BornaBiro/Diplomski_rad/Case, 3D models/FreeCAD Files/WindDirection/Notes.txt

Arrow holder: 15% Infill, 4 perimeters, 0,45mm extrusion width
Wing: 15% Infill, 4 perimeters, 0,45mm extrusion width
