BornaBiro/Diplomski_rad/Case, 3D models/FreeCAD Files/RainGaugeTippingBucket/tipping_bucket_holder.FCStd

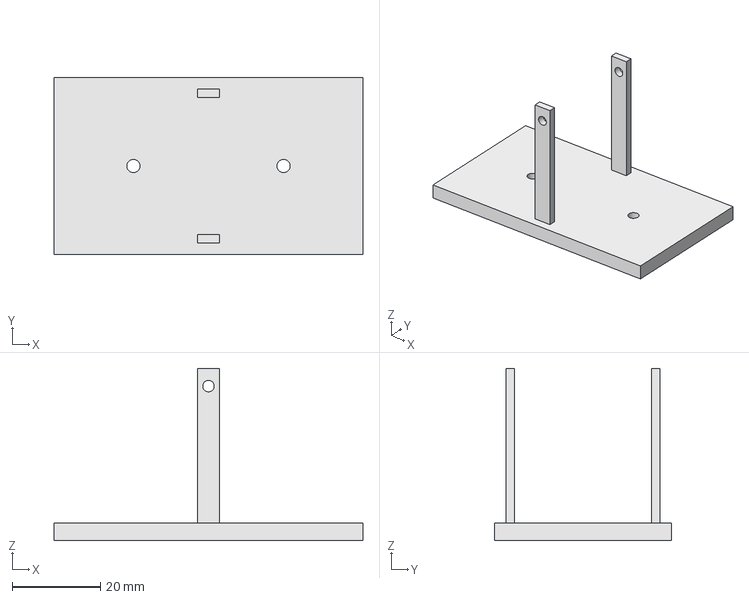
[picture p1: CAD file, 2021-11-29]
Case, 3D models/FreeCAD Files/RainGaugeTippingBucket/tipping_bucket_holder.FCStd
70.0 x 40.0 x 39.0 mm
