BornaBiro/Diplomski_rad/Case, 3D models/FreeCAD Files/solar_panel_clip.FCStd

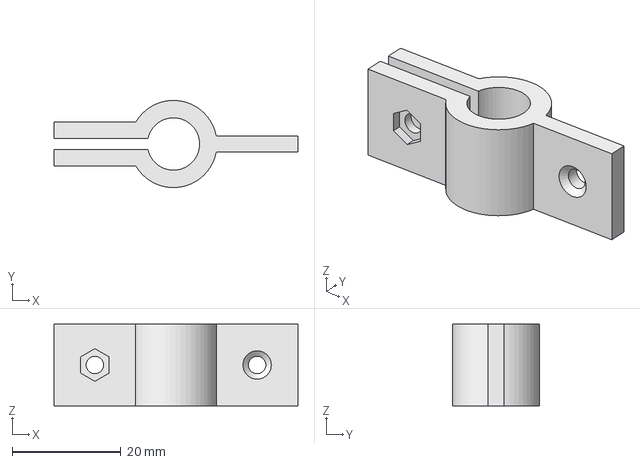
[picture p2: CAD file, 2021-11-29]
Case, 3D models/FreeCAD Files/solar_panel_clip.FCStd
44.8 x 16.0 x 15.0 mm
