BornaBiro/Diplomski_rad/Case, 3D models/FreeCAD Files/WindDirection/windDirectionSensorHousing.FCStd

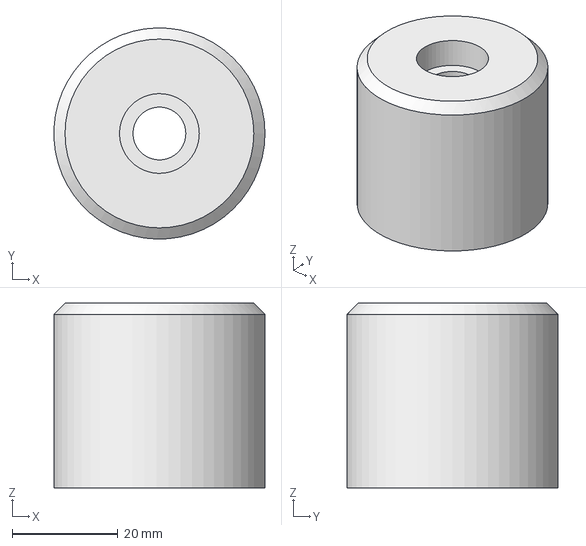
[picture p3: CAD file, 2021-11-29]
Case, 3D models/FreeCAD Files/WindDirection/windDirectionSensorHousing.FCStd
40.0 x 40.0 x 35.0 mm
