BornaBiro/Diplomski_rad/Case, 3D models/FreeCAD Files/WindSpeed/windSensorHolder.FCStd

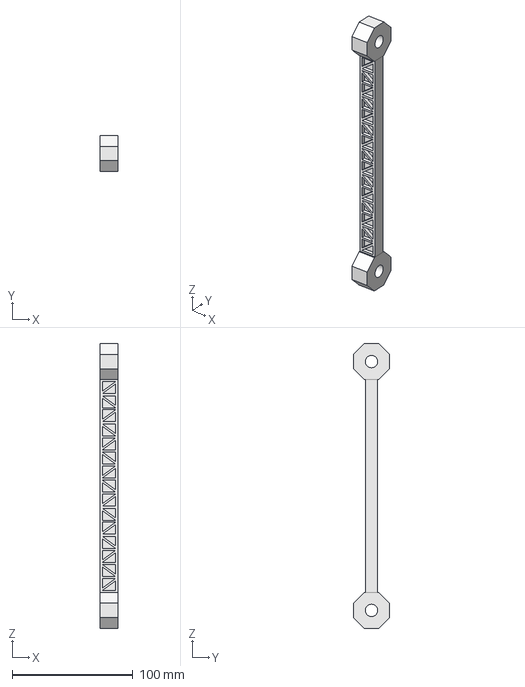
[picture p4: CAD file, 2022-10-31]
Case, 3D models/FreeCAD Files/WindSpeed/windSensorHolder.FCStd
15.0 x 30.0 x 236.0 mm
