BornaBiro/Diplomski_rad/Case, 3D models/FreeCAD Files/Ball_joint1.FCStd

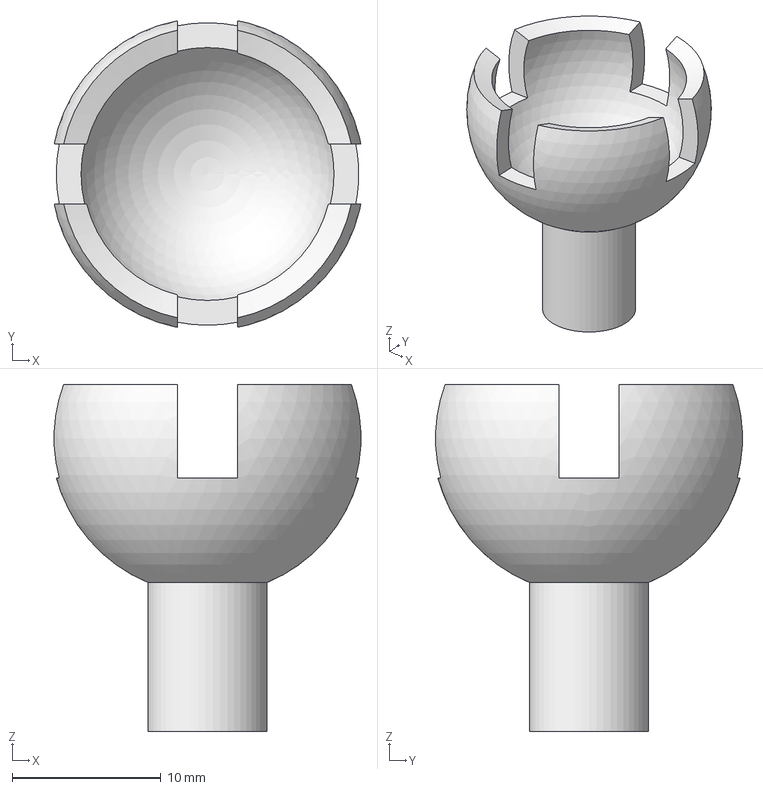
[picture p5: CAD file, 2021-11-29]
Case, 3D models/FreeCAD Files/Ball_joint1.FCStd
20.6 x 20.6 x 23.3 mm
