BornaBiro/Diplomski_rad/Case, 3D models/FreeCAD Files/WindDirection/windDirectionWing.FCStd

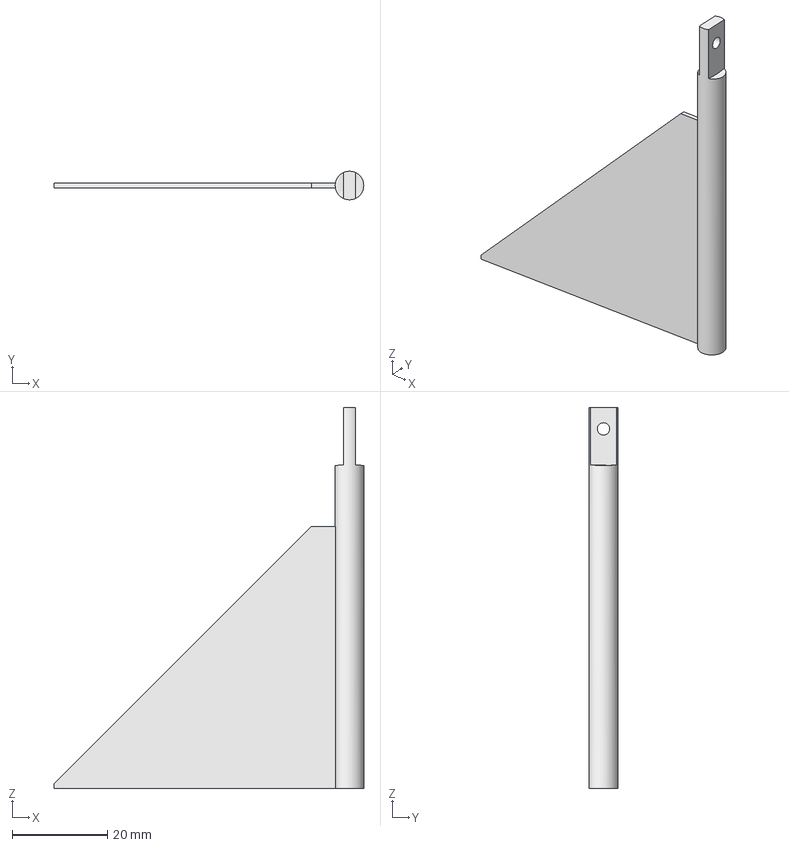
[picture p7: CAD file, 2021-11-29]
Case, 3D models/FreeCAD Files/WindDirection/windDirectionWing.FCStd
65.0 x 6.00 x 80.0 mm
