BornaBiro/Diplomski_rad/Case, 3D models/FreeCAD Files/WindSpeed/bearingHolderWindv3.FCStd

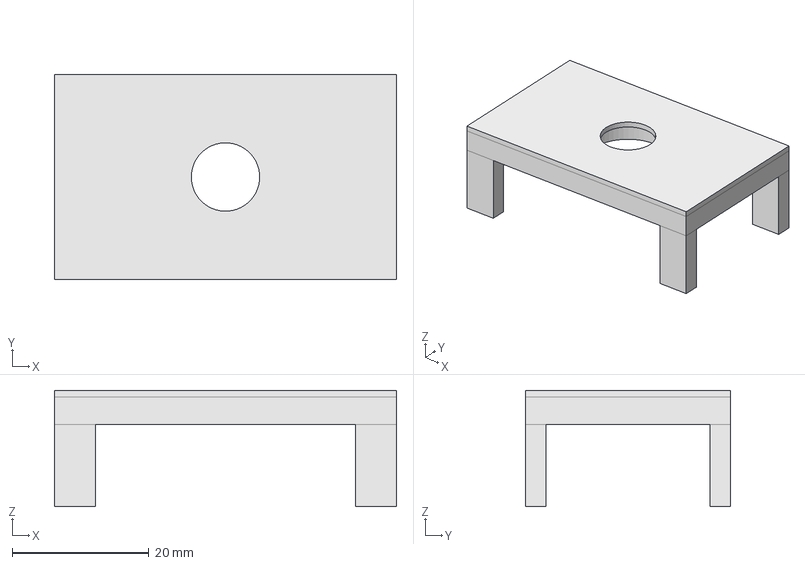
[picture p8: CAD file, 2021-11-29]
Case, 3D models/FreeCAD Files/WindSpeed/bearingHolderWindv3.FCStd
50.0 x 30.0 x 17.0 mm
