BornaBiro/Diplomski_rad/Case, 3D models/FreeCAD Files/Ball_joint2.FCStd

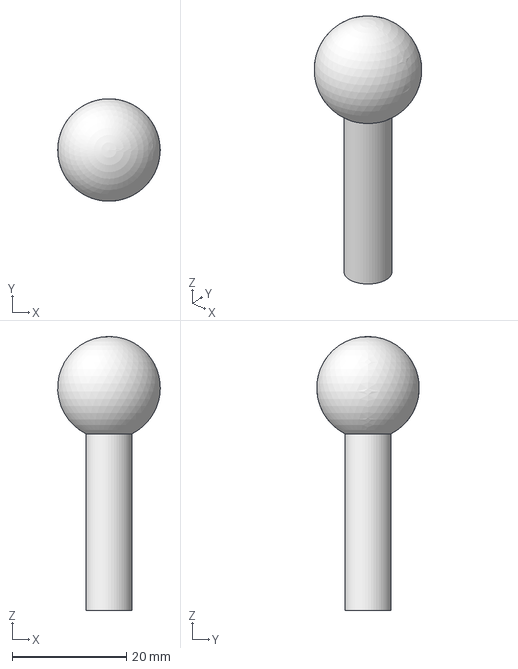
[picture p9: CAD file, 2021-11-29]
Case, 3D models/FreeCAD Files/Ball_joint2.FCStd
18.0 x 17.9 x 48.0 mm
