BornaBiro/Diplomski_rad/Case, 3D models/FreeCAD Files/RainGaugeTippingBucket/2ml.FCStd

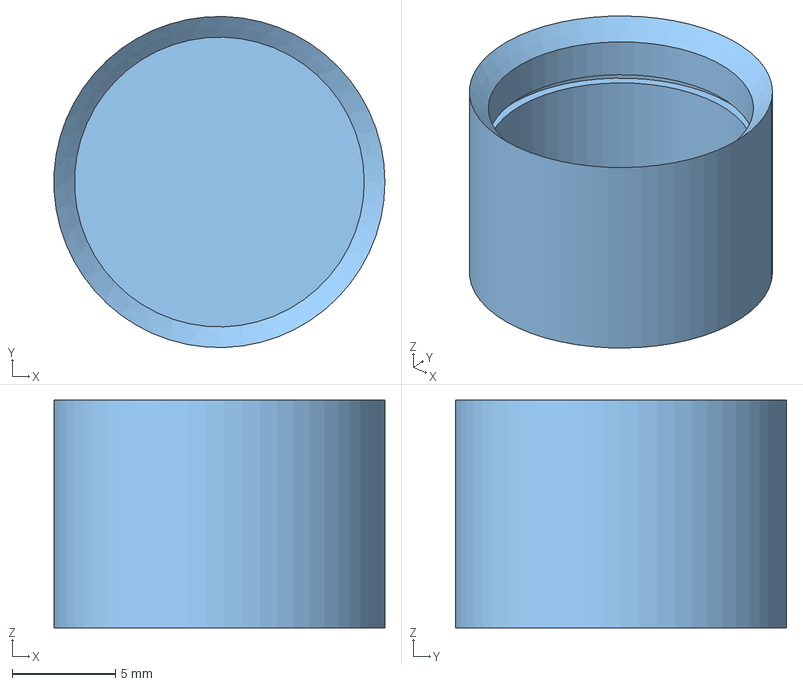
[picture p10: CAD file, 2021-11-29]
Case, 3D models/FreeCAD Files/RainGaugeTippingBucket/2ml.FCStd
16.0 x 16.0 x 11.0 mm
ShapeString
