BornaBiro/Diplomski_rad/Case, 3D models/FreeCAD Files/WindDirection/windDirectionPCB.FCStd

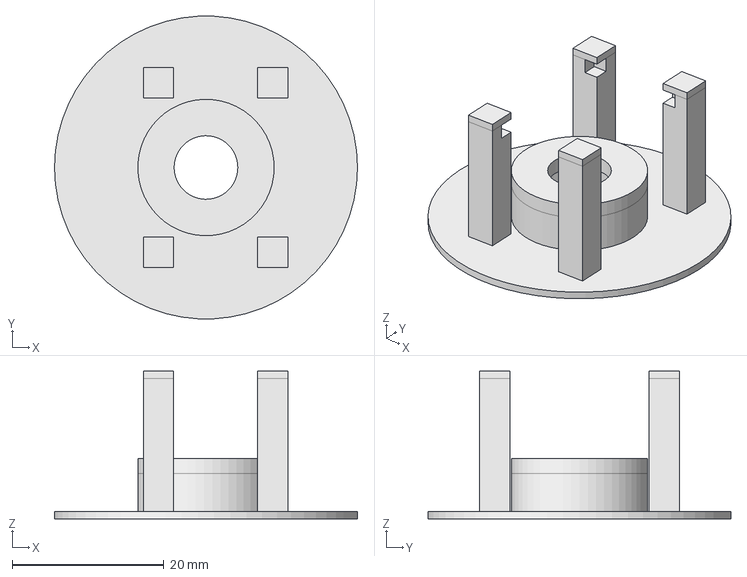
[picture p11: CAD file, 2021-11-29]
Case, 3D models/FreeCAD Files/WindDirection/windDirectionPCB.FCStd
40.0 x 39.9 x 19.5 mm
