BornaBiro/Diplomski_rad/Case, 3D models/FreeCAD Files/WindSpeed/WindGear3.FCStd

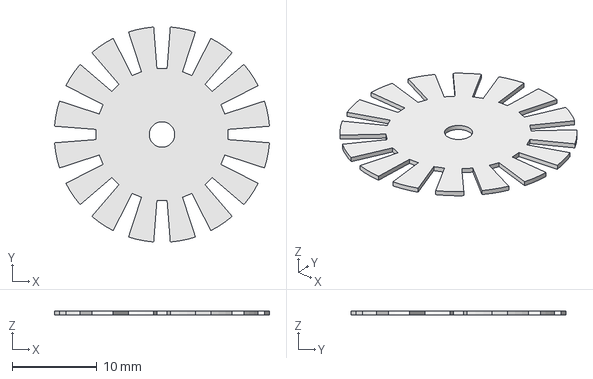
[picture p12: CAD file, 2021-11-29]
Case, 3D models/FreeCAD Files/WindSpeed/WindGear3.FCStd
25.3 x 25.3 x 0.5 mm
