BornaBiro/Diplomski_rad/Case, 3D models/FreeCAD Files/Outdoor_solar_panel.FCStd

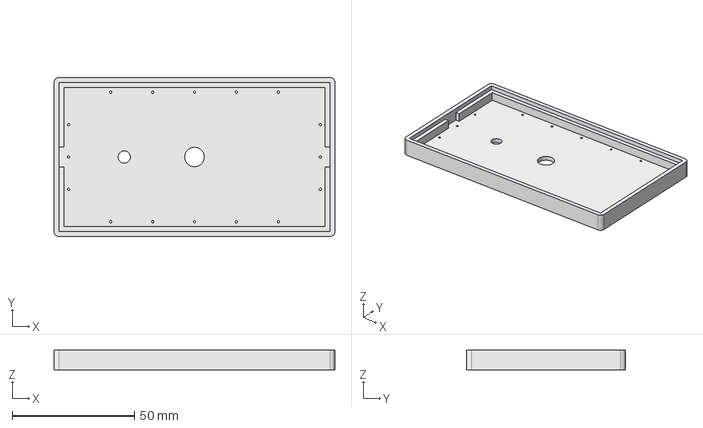
[picture p13: CAD file, 2021-11-29]
Case, 3D models/FreeCAD Files/Outdoor_solar_panel.FCStd
115.0 x 65.0 x 8.00 mm
