BornaBiro/Diplomski_rad/Case, 3D models/FreeCAD Files/RainGaugeTippingBucket/tipping_bucket.FCStd

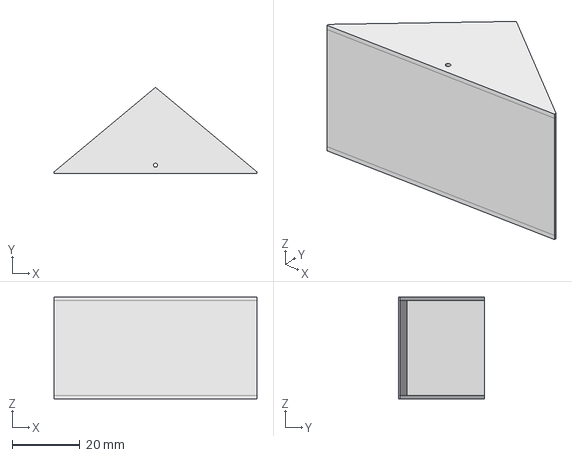
[picture p14: CAD file, 2021-11-29]
Case, 3D models/FreeCAD Files/RainGaugeTippingBucket/tipping_bucket.FCStd
60.0 x 25.5 x 30.1 mm
