BornaBiro/Diplomski_rad/Case, 3D models/FreeCAD Files/WindDirection/windDirectionArrowTop.FCStd

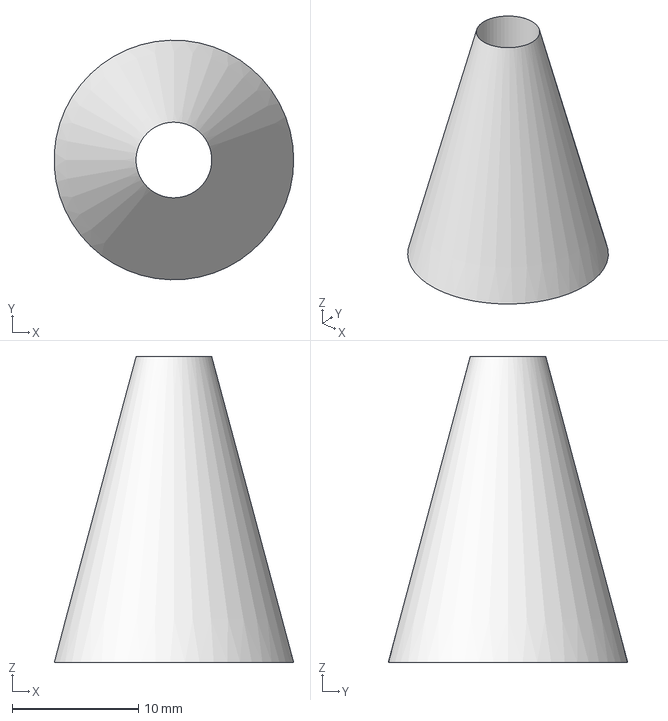
[picture p15: CAD file, 2021-11-29]
Case, 3D models/FreeCAD Files/WindDirection/windDirectionArrowTop.FCStd
19.0 x 19.0 x 24.3 mm
