BornaBiro/Diplomski_rad/Case, 3D models/FreeCAD Files/WindSpeed/windCupv5.FCStd

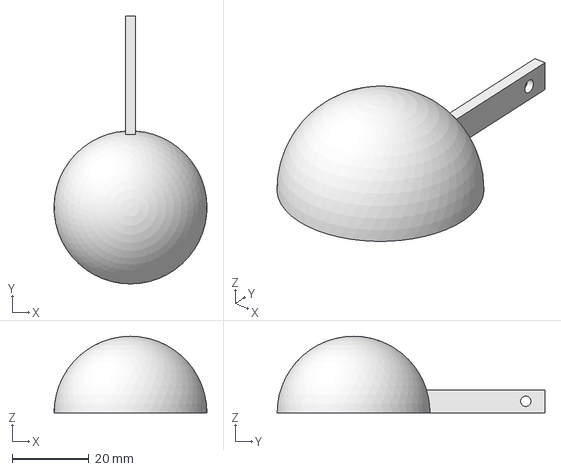
[picture p16: CAD file, 2021-11-29]
Case, 3D models/FreeCAD Files/WindSpeed/windCupv5.FCStd
40.0 x 70.0 x 20.0 mm
