BornaBiro/Diplomski_rad/Case, 3D models/FreeCAD Files/WindDirection/windDirectionArrowHolder.FCStd

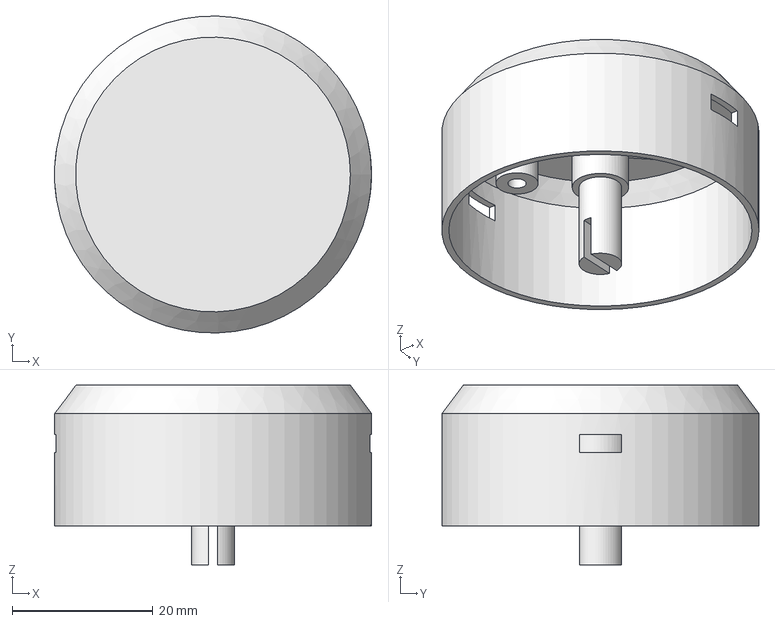
[picture p17: CAD file, 2021-11-29]
Case, 3D models/FreeCAD Files/WindDirection/windDirectionArrowHolder.FCStd
45.0 x 45.0 x 25.5 mm
