BornaBiro/Diplomski_rad/Case, 3D models/FreeCAD Files/WindSpeed/WindGear.FCStd

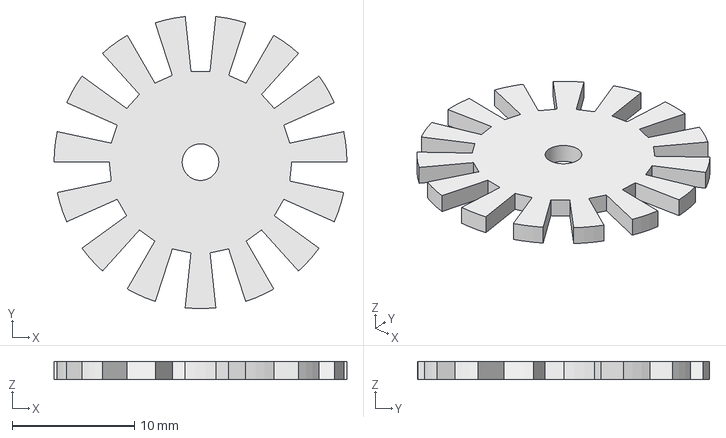
[picture p18: CAD file, 2021-11-29]
Case, 3D models/FreeCAD Files/WindSpeed/WindGear.FCStd
24.0 x 23.9 x 1.50 mm
