BornaBiro/Diplomski_rad/Case, 3D models/FreeCAD Files/WindDirection/windDirectionArrow.FCStd

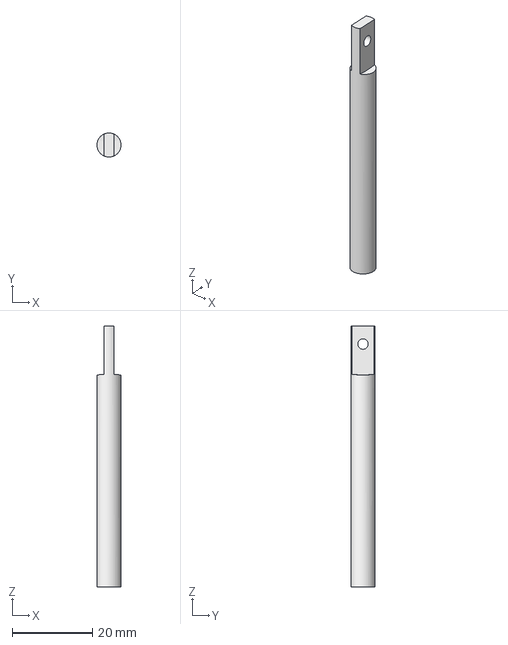
[picture p19: CAD file, 2021-11-29]
Case, 3D models/FreeCAD Files/WindDirection/windDirectionArrow.FCStd
6.00 x 6.00 x 65.0 mm
