BornaBiro/Diplomski_rad/Case, 3D models/FreeCAD Files/WindSpeed/windSensorHousingBottomv2.FCStd

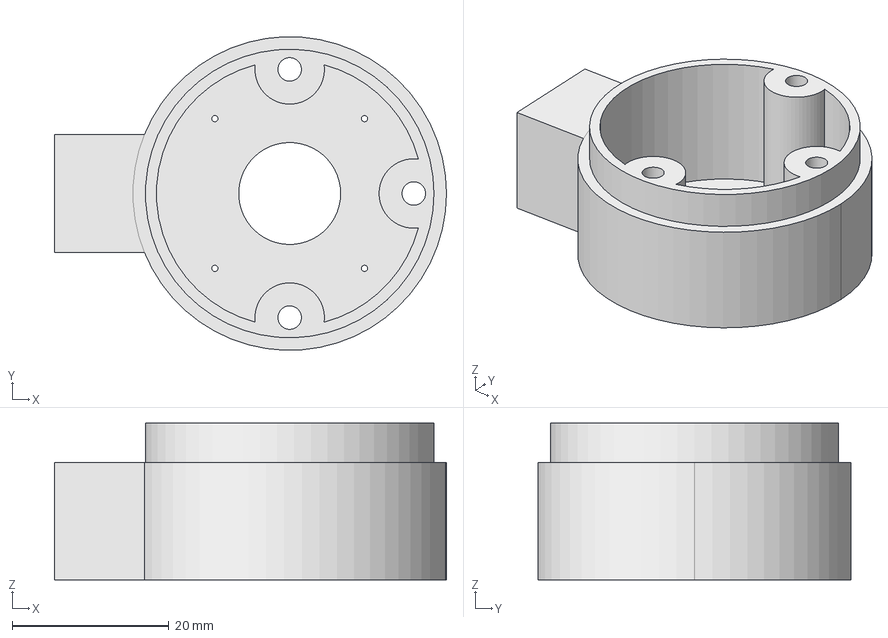
[picture p20: CAD file, 2021-11-29]
Case, 3D models/FreeCAD Files/WindSpeed/windSensorHousingBottomv2.FCStd
50.0 x 40.0 x 20.0 mm
