BornaBiro/Diplomski_rad/Case, 3D models/FreeCAD Files/WindDirection/windDirectionArrowTopv2.FCStd

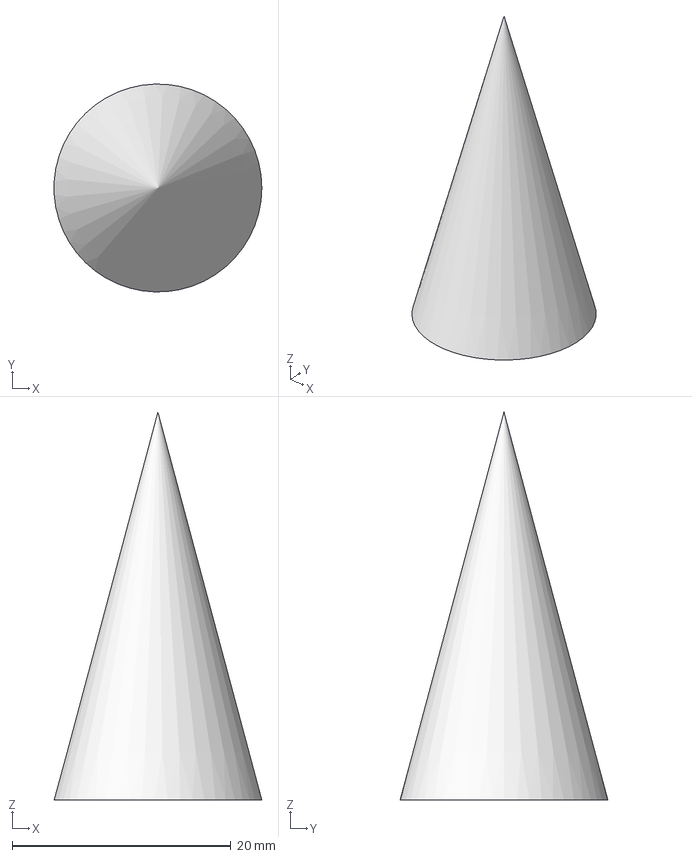
[picture p21: CAD file, 2021-11-29]
Case, 3D models/FreeCAD Files/WindDirection/windDirectionArrowTopv2.FCStd
19.0 x 19.0 x 35.5 mm
