BornaBiro/Diplomski_rad/Case, 3D models/FreeCAD Files/WindSpeed/windCupv4.FCStd

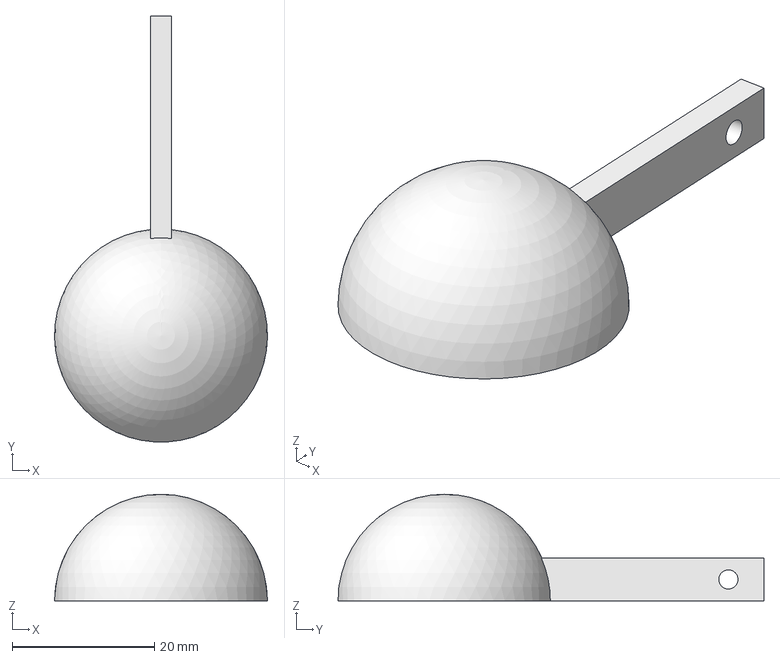
[picture p22: CAD file, 2021-11-29]
Case, 3D models/FreeCAD Files/WindSpeed/windCupv4.FCStd
30.0 x 60.0 x 15.0 mm
