BornaBiro/Diplomski_rad/Case, 3D models/FreeCAD Files/WindDirection/windDIrectionShaft.FCStd

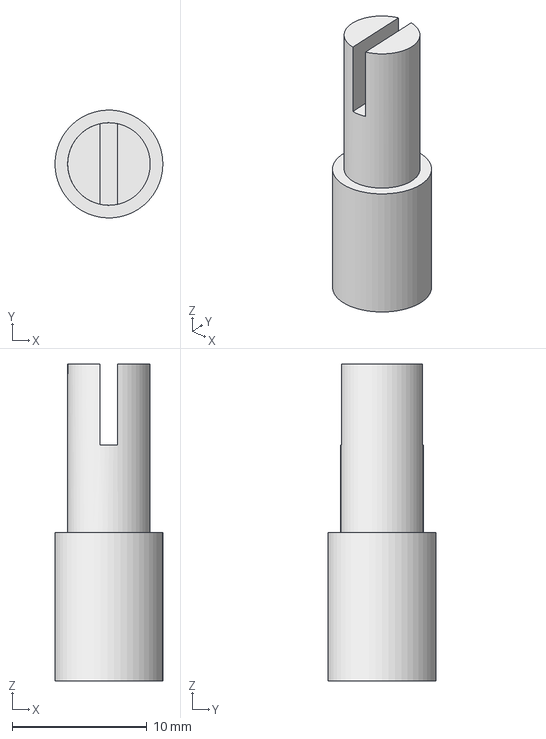
[picture p23: CAD file, 2021-11-29]
Case, 3D models/FreeCAD Files/WindDirection/windDIrectionShaft.FCStd
7.99 x 8.00 x 23.5 mm
