BornaBiro/Diplomski_rad/Case, 3D models/FreeCAD Files/WindSpeed/windCupHolder.FCStd

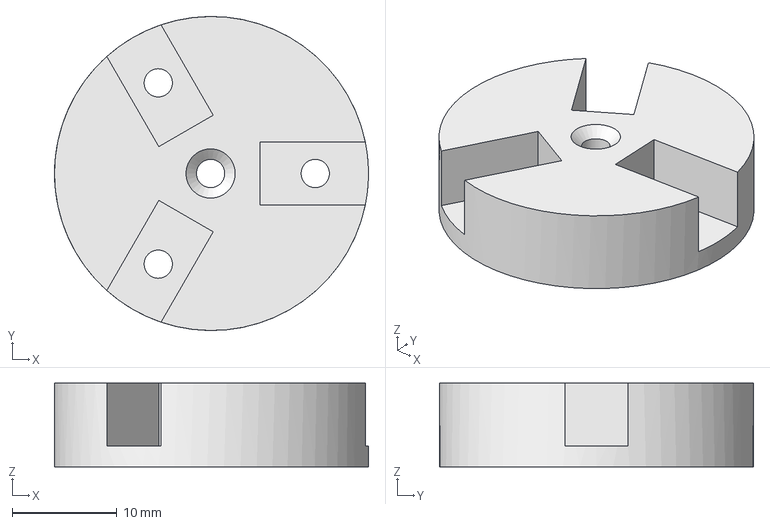
[picture p24: CAD file, 2021-11-29]
Case, 3D models/FreeCAD Files/WindSpeed/windCupHolder.FCStd
30.0 x 30.0 x 8.00 mm
