BornaBiro/Diplomski_rad/Case, 3D models/FreeCAD Files/WindDirection/windDirectionHolder.FCStd

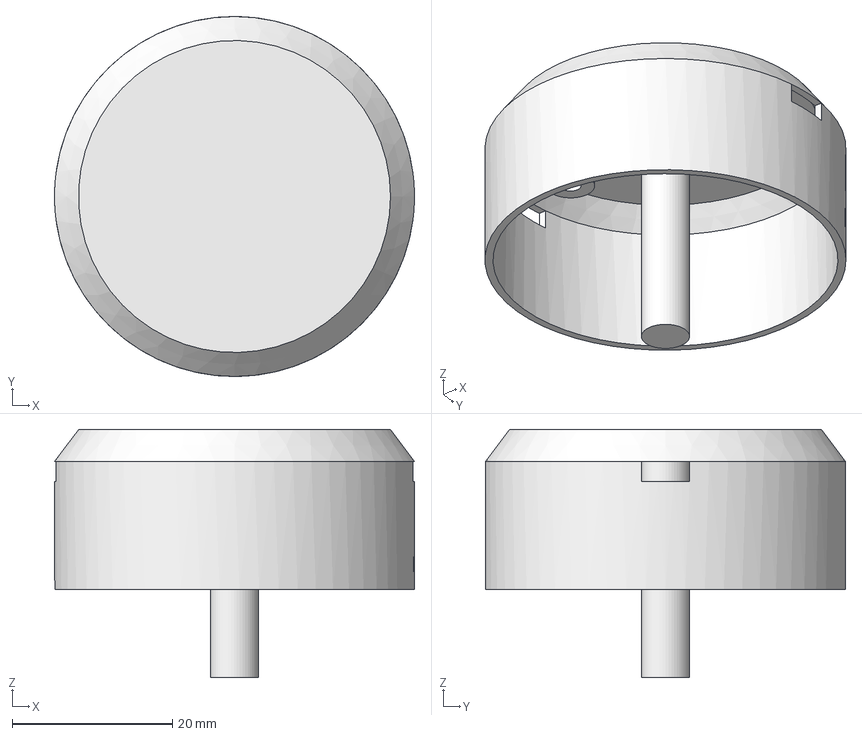
[picture p25: CAD file, 2021-11-29]
Case, 3D models/FreeCAD Files/WindDirection/windDirectionHolder.FCStd
45.0 x 45.0 x 31.0 mm
