BornaBiro/Diplomski_rad/Case, 3D models/FreeCAD Files/WindSpeed/WindGear2.FCStd

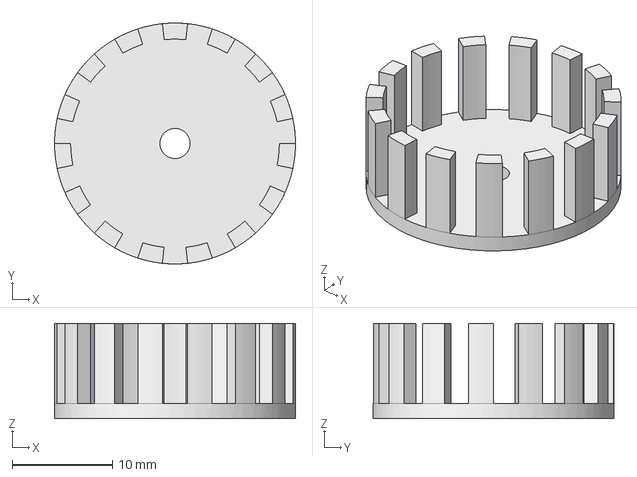
[picture p26: CAD file, 2021-11-29]
Case, 3D models/FreeCAD Files/WindSpeed/WindGear2.FCStd
24.0 x 24.0 x 9.50 mm
