BornaBiro/Diplomski_rad/Case, 3D models/FreeCAD Files/WindSpeed/windCupv6.FCStd

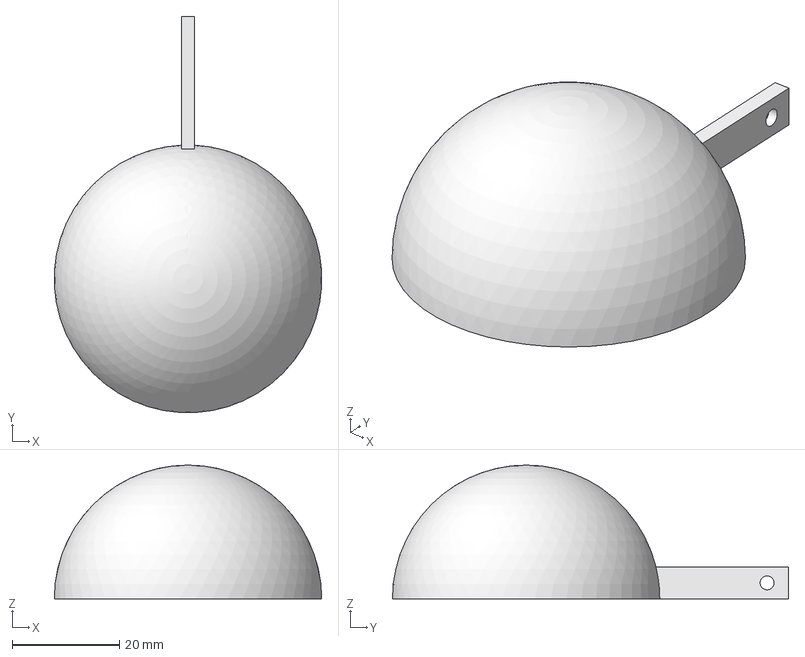
[picture p27: CAD file, 2021-11-29]
Case, 3D models/FreeCAD Files/WindSpeed/windCupv6.FCStd
49.9 x 74.0 x 25.0 mm
