BornaBiro/Diplomski_rad/Case, 3D models/FreeCAD Files/WindSpeed/windSensorHousing.FCStd

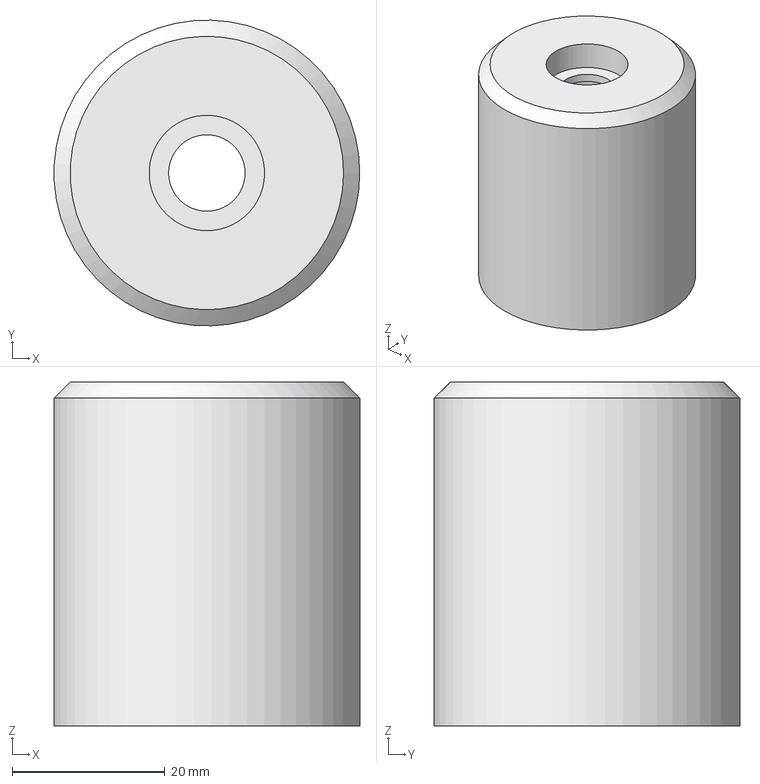
[picture p28: CAD file, 2021-11-29]
Case, 3D models/FreeCAD Files/WindSpeed/windSensorHousing.FCStd
40.0 x 40.0 x 45.0 mm
