BornaBiro/Diplomski_rad/Case, 3D models/FreeCAD Files/WindSpeed/windCupv2.FCStd

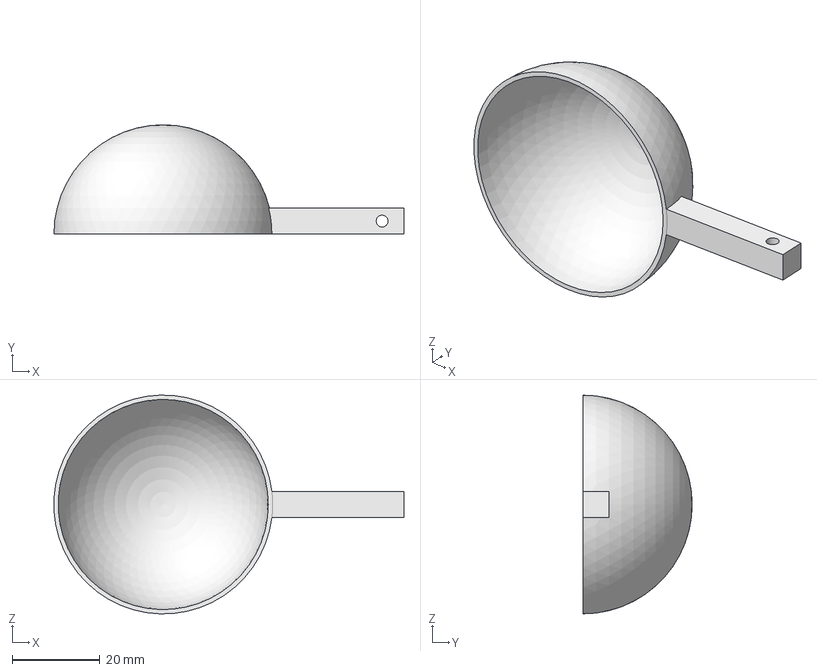
[picture p29: CAD file, 2021-11-29]
Case, 3D models/FreeCAD Files/WindSpeed/windCupv2.FCStd
80.0 x 25.0 x 50.0 mm
