BornaBiro/Diplomski_rad/Case, 3D models/FreeCAD Files/WindSpeed/windSensorHousingv2.FCStd

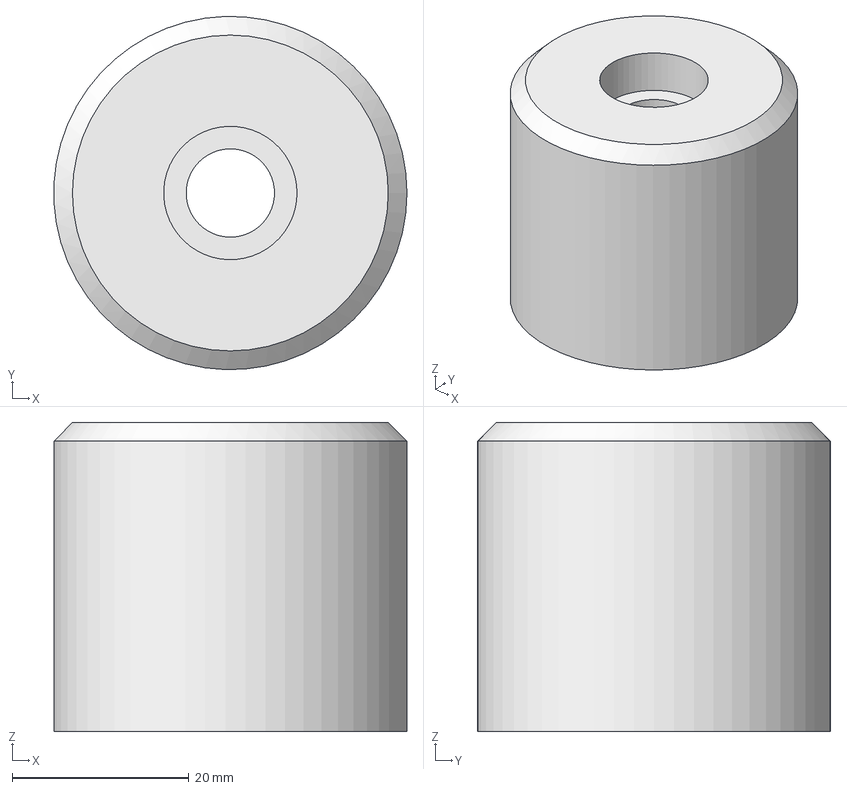
[picture p30: CAD file, 2021-11-29]
Case, 3D models/FreeCAD Files/WindSpeed/windSensorHousingv2.FCStd
40.0 x 40.0 x 35.0 mm
