BornaBiro/Diplomski_rad/Case, 3D models/FreeCAD Files/WindSpeed/windCupv1.FCStd

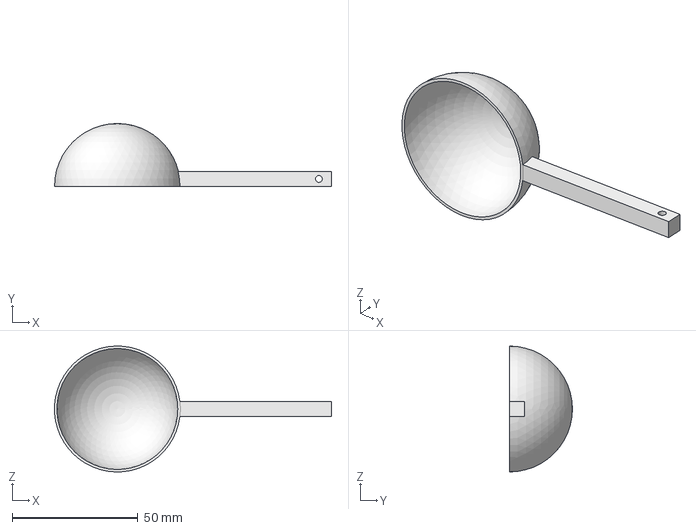
[picture p31: CAD file, 2021-11-29]
Case, 3D models/FreeCAD Files/WindSpeed/windCupv1.FCStd
110.0 x 25.0 x 50.0 mm
