BornaBiro/Diplomski_rad/Case, 3D models/FreeCAD Files/WindSpeed/windCupv3.FCStd

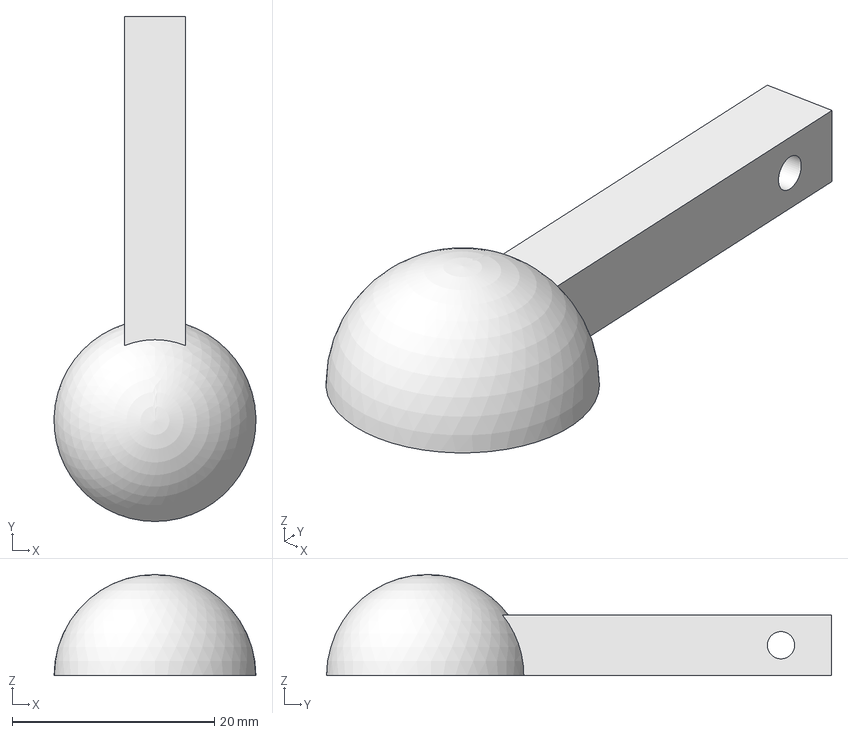
[picture p32: CAD file, 2021-11-29]
Case, 3D models/FreeCAD Files/WindSpeed/windCupv3.FCStd
20.0 x 50.0 x 10.0 mm
