BornaBiro/Diplomski_rad/Case, 3D models/FreeCAD Files/WindSpeed/windCupHolderv3.FCStd

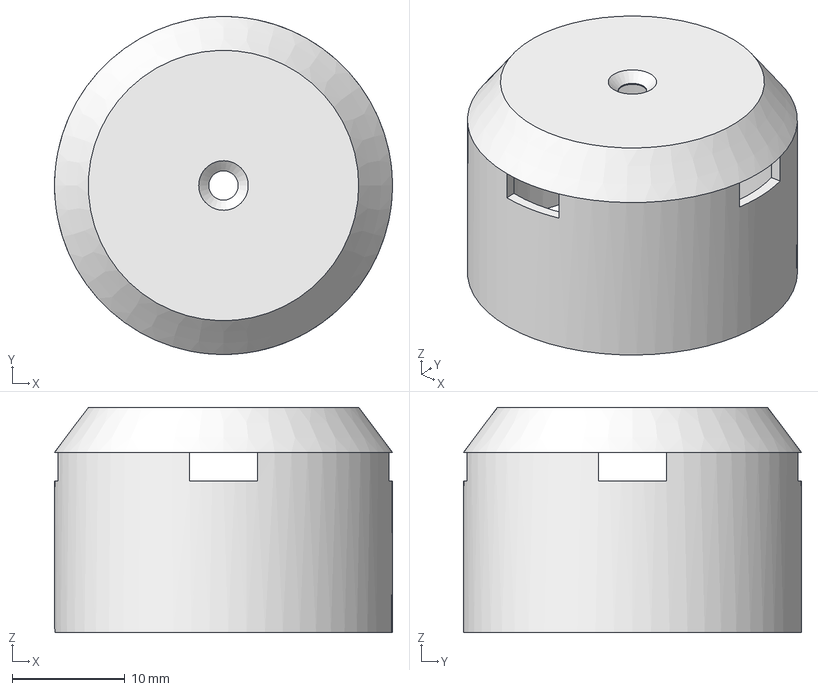
[picture p33: CAD file, 2021-11-29]
Case, 3D models/FreeCAD Files/WindSpeed/windCupHolderv3.FCStd
30.0 x 30.0 x 20.0 mm
