BornaBiro/Diplomski_rad/Case, 3D models/FreeCAD Files/WindSpeed/windCupHolderv2.FCStd

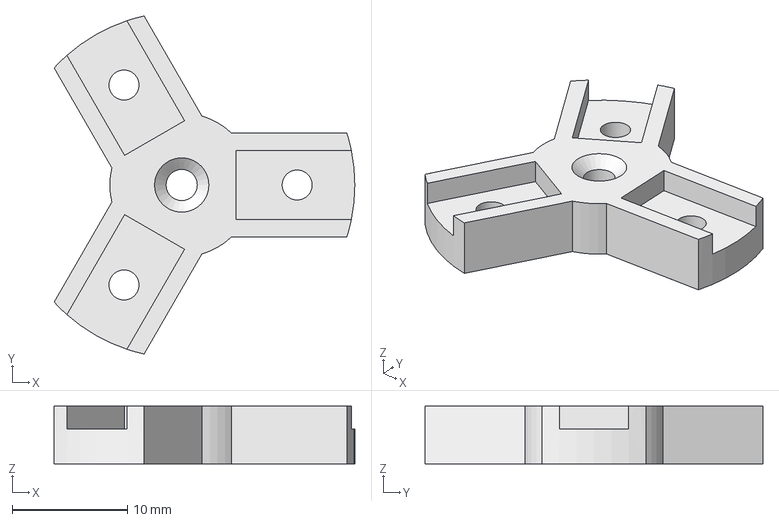
[picture p34: CAD file, 2021-11-29]
Case, 3D models/FreeCAD Files/WindSpeed/windCupHolderv2.FCStd
26.1 x 29.3 x 5.00 mm
