BornaBiro/Diplomski_rad/Case, 3D models/FreeCAD Files/WindSpeed/windCupv7.FCStd

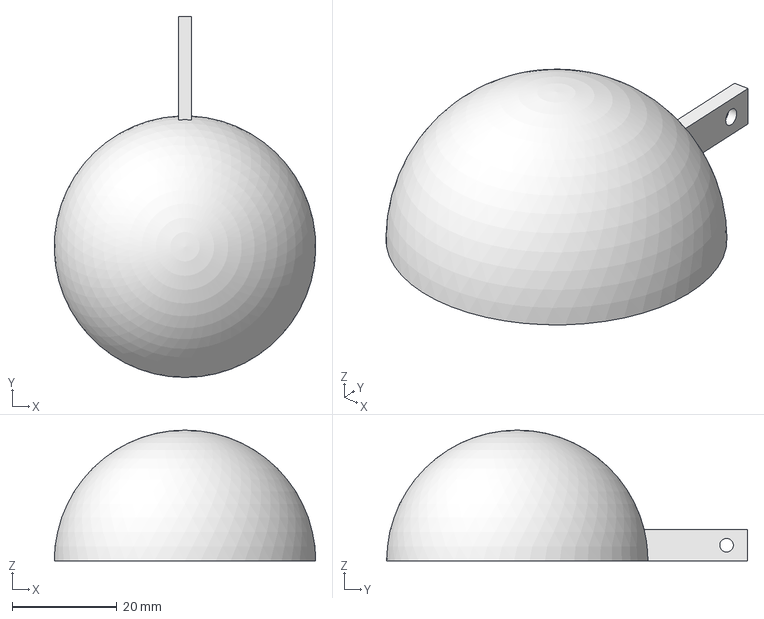
[picture p35: CAD file, 2021-11-29]
Case, 3D models/FreeCAD Files/WindSpeed/windCupv7.FCStd
50.0 x 69.0 x 25.0 mm
