BornaBiro/Diplomski_rad/Case, 3D models/FreeCAD Files/WindSpeed/windShaft.FCStd

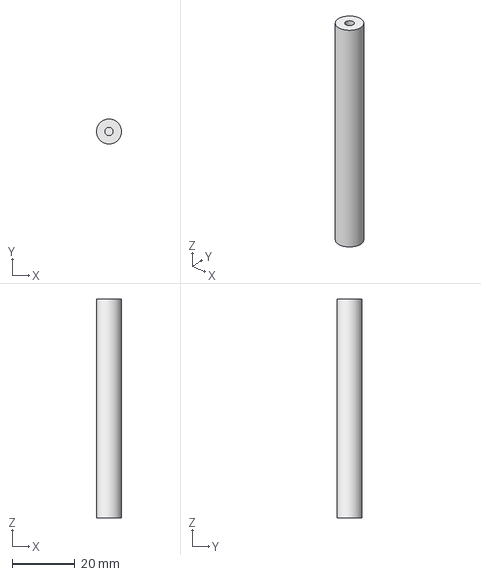
[picture p36: CAD file, 2021-11-29]
Case, 3D models/FreeCAD Files/WindSpeed/windShaft.FCStd
7.99 x 8.00 x 70.0 mm
