BornaBiro/Diplomski_rad/Case, 3D models/FreeCAD Files/WindSpeed/windShaftv2.FCStd

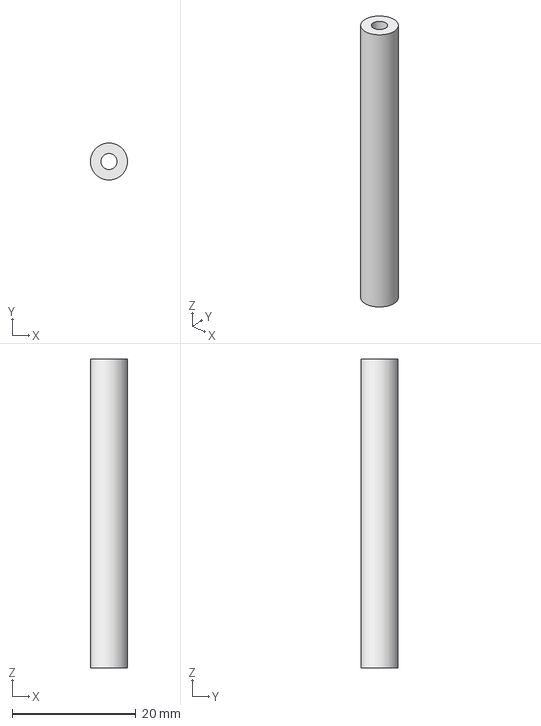
[picture p37: CAD file, 2021-11-29]
Case, 3D models/FreeCAD Files/WindSpeed/windShaftv2.FCStd
5.99 x 6.00 x 50.0 mm
