BornaBiro/Diplomski_rad/Case, 3D models/FreeCAD Files/WindSpeed/windCupHolderv4.FCStd

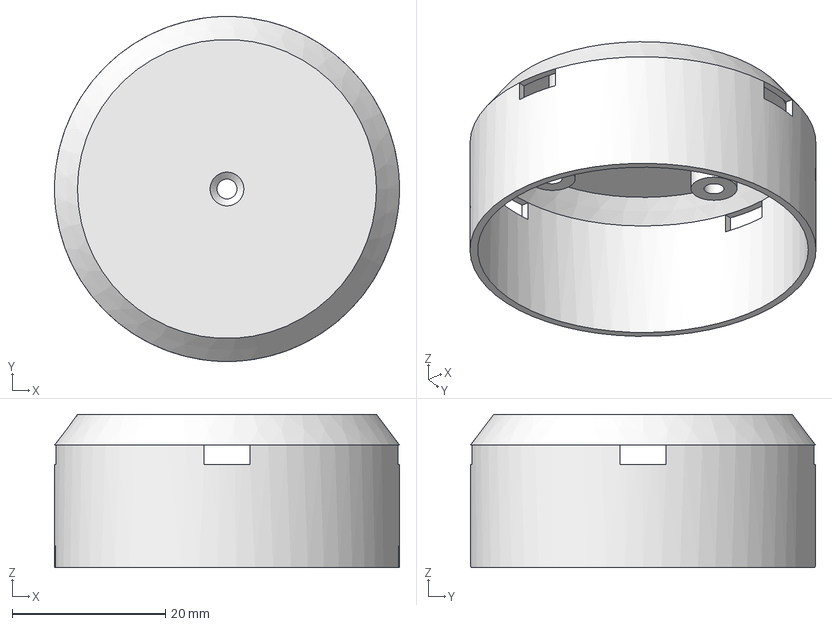
[picture p38: CAD file, 2021-11-29]
Case, 3D models/FreeCAD Files/WindSpeed/windCupHolderv4.FCStd
45.0 x 45.0 x 20.0 mm
