BornaBiro/Diplomski_rad/Case, 3D models/FreeCAD Files/WindSpeed/windShaftv3.FCStd

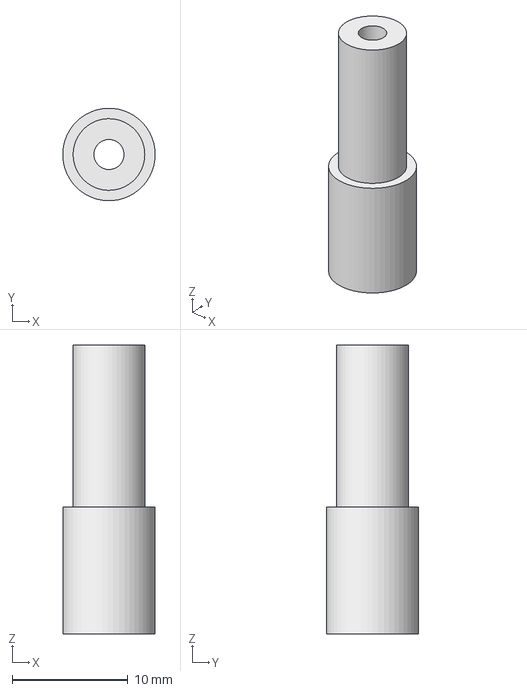
[picture p39: CAD file, 2021-11-29]
Case, 3D models/FreeCAD Files/WindSpeed/windShaftv3.FCStd
7.99 x 8.00 x 25.0 mm
