BornaBiro/Diplomski_rad/Case, 3D models/FreeCAD Files/WindSpeed/bearingHolderWindv2.FCStd

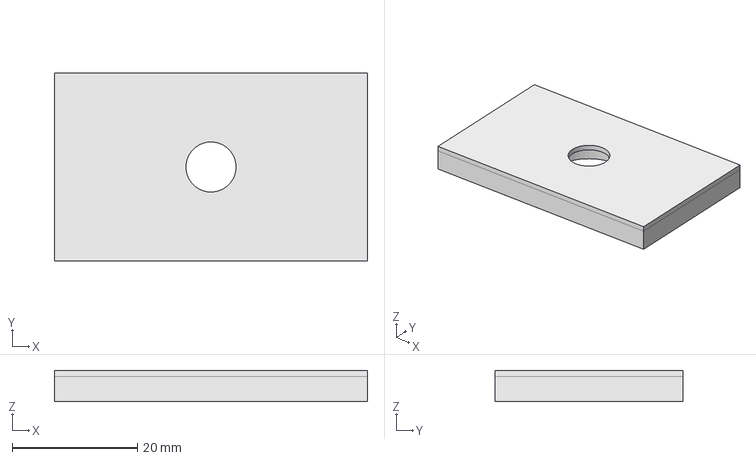
[picture p40: CAD file, 2021-11-29]
Case, 3D models/FreeCAD Files/WindSpeed/bearingHolderWindv2.FCStd
50.0 x 30.0 x 5.00 mm
