BornaBiro/Diplomski_rad/Case, 3D models/FreeCAD Files/WindSpeed/windCupHolderv5.FCStd

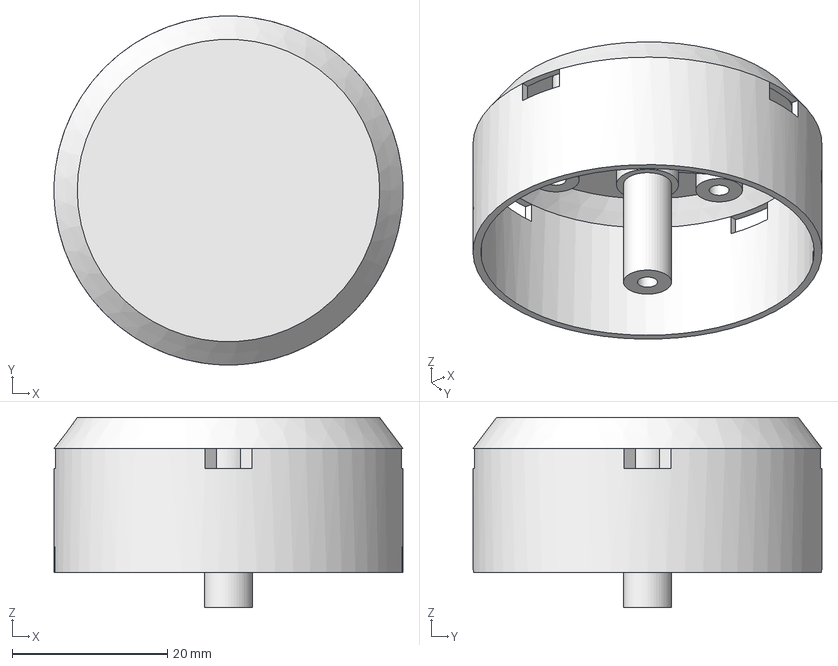
[picture p41: CAD file, 2021-11-29]
Case, 3D models/FreeCAD Files/WindSpeed/windCupHolderv5.FCStd
45.0 x 45.0 x 24.5 mm
