BornaBiro/Diplomski_rad/Case, 3D models/FreeCAD Files/WindSpeed/bearingHolderWind.FCStd

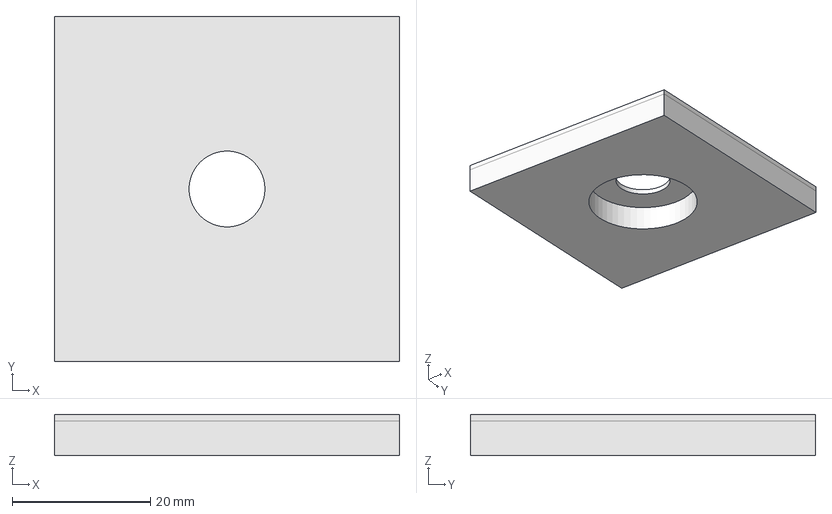
[picture p42: CAD file, 2021-11-29]
Case, 3D models/FreeCAD Files/WindSpeed/bearingHolderWind.FCStd
50.0 x 50.0 x 6.00 mm
