BornaBiro/Diplomski_rad/(list of files, cad)

Other CAD files:
Case, 3D models/FreeCAD Files/WindSpeed/windSensorHousingBottom.FCStd
