BornaBiro/Diplomski_rad/PCBs/Outdoor_unit_light_board.brd

## EAGLE design PCBs/Outdoor_unit_light_board.brd (2021-11-29)

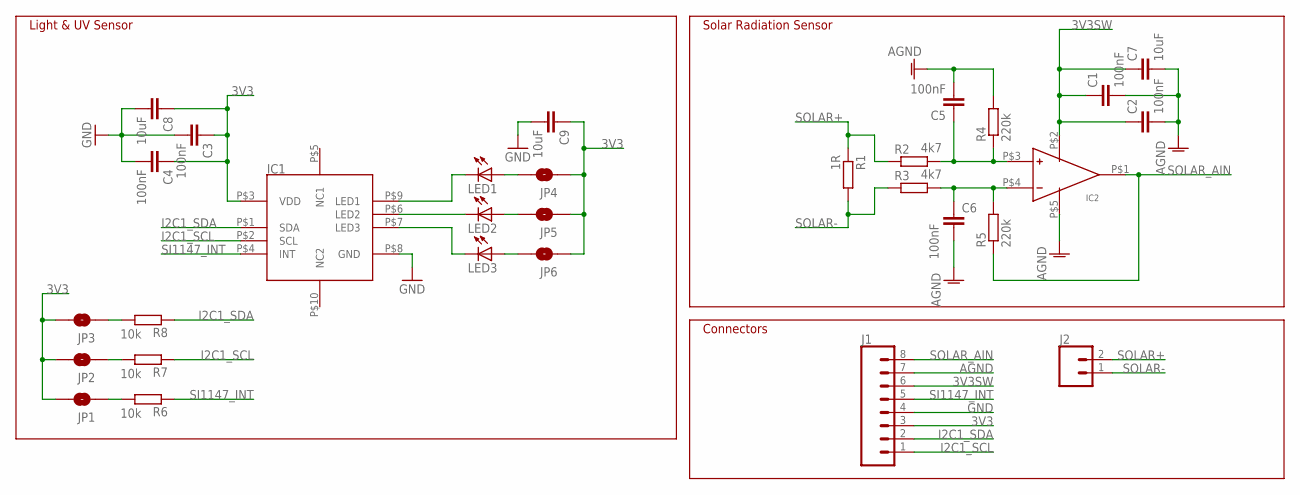
[picture p43: schematic Outdoor_unit_light_board.sch]

Parts:
C1, C2, C3, C4, C5, C6: 100nF; C0603K
C7, C8, C9: 10uF; C1206K
IC1: SI1147-A10-GMR; QFN10
IC2: MCP601RT-I/OT; SOT23-5
J1: CONN_08"; 1X08
J2: CONN_02; 1X02
JP1, JP2, JP3, JP4, JP5, JP6: JUMPER-SMT_2_NO_SILK; SMT-JUMPER_2_NO_SILK
LED1, LED2, LED3: LEDCHIPLED_0603; CHIPLED_0603
R1: 1R; R0603
R2, R3: 4k7; R0603
R4, R5: 220k; R0603
R6, R7, R8: 10k; R0603

Connections:
3V3: C3.1, C4.1, C8.1, C9.1, IC1.P$3 (VDD), J1.3, JP1.2, JP2.2, JP3.2, JP4.1, JP5.1, JP6.1
3V3SW: C1.1, C2.1, C7.1, IC2.P$2 (VDD), J1.6
AGND: C1.2, C2.2, C5.2, C6.2, C7.2, IC2.P$5 (VSS), J1.7, R4.2
GND: C3.2, C4.2, C8.2, C9.2, IC1.P$8 (GND), J1.4
I2C1_SCL: IC1.P$2 (SCL), J1.1, R7.1
I2C1_SDA: IC1.P$1 (SDA), J1.2, R8.1
unnamed: IC1.P$6 (LED2), LED2.C
unnamed: C5.1, IC2.P$3 (+IN), R2.2, R4.1
unnamed: C6.1, IC2.P$4 (-IN), R3.2, R5.2
unnamed: IC1.P$7 (LED3), LED3.C
unnamed: IC1.P$9 (LED1), LED1.C
unnamed: JP1.1, R6.2
unnamed: JP4.2, LED1.A
unnamed: JP5.2, LED2.A
unnamed: JP6.2, LED3.A
unnamed: JP2.1, R7.2
unnamed: JP3.1, R8.2
SI1147_INT: IC1.P$4 (INT), J1.5, R6.1
SOLAR+: J2.2, R1.1, R2.1
SOLAR-: J2.1, R1.2, R3.1
SOLAR_AIN: IC2.P$1 (OUT), J1.8, R5.1

Notes on the sheet:
Solar Radiation Sensor
Light & UV Sensor
Connectors

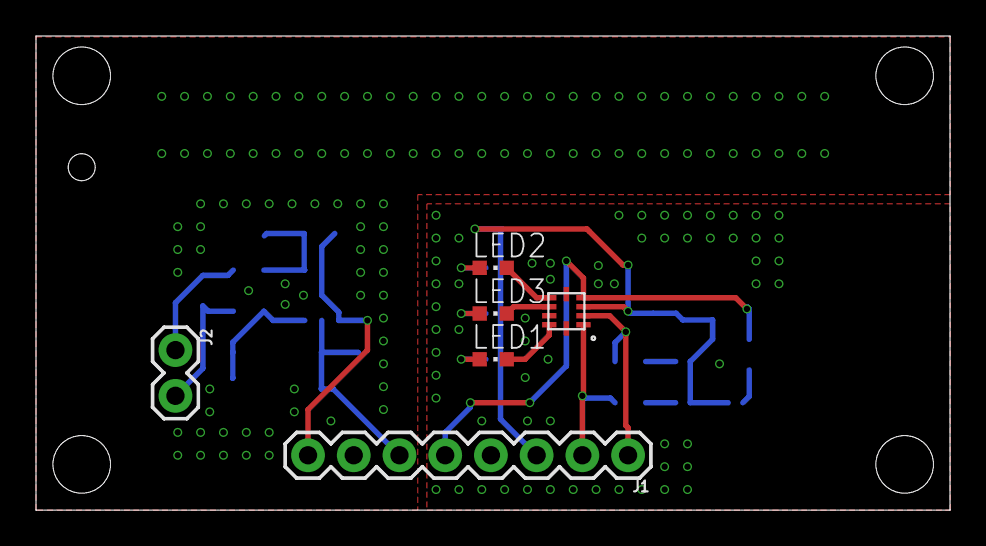
[picture p44: board Outdoor_unit_light_board.brd from above]

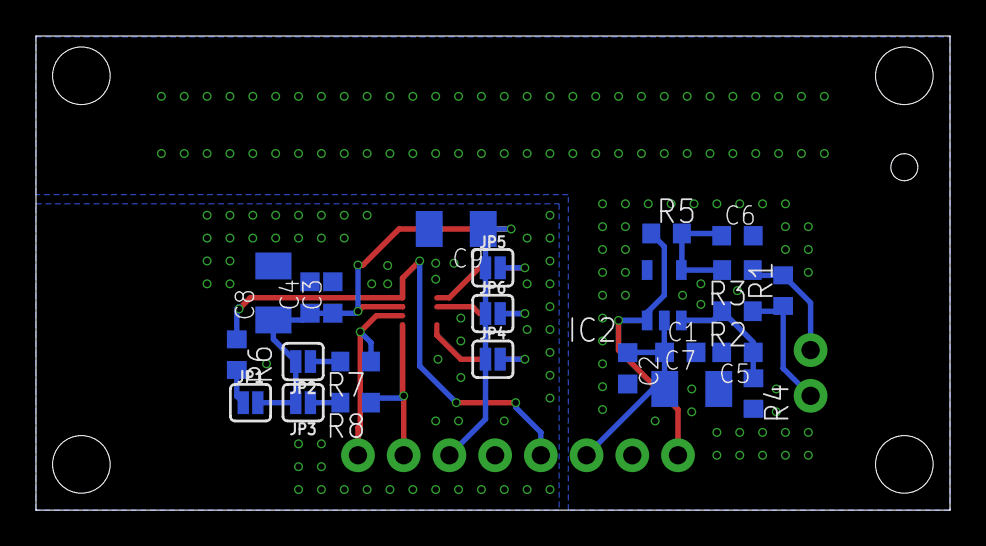
[picture p45: board Outdoor_unit_light_board.brd from below]

Board: 2 copper layers, 50.8 x 26.3 mm, 30 parts (24 on the bottom side), 21 nets.
