BornaBiro/Diplomski_rad/PCBs/Outdoor_unit_main_board.brd

## EAGLE design PCBs/Outdoor_unit_main_board.brd (2021-11-29)

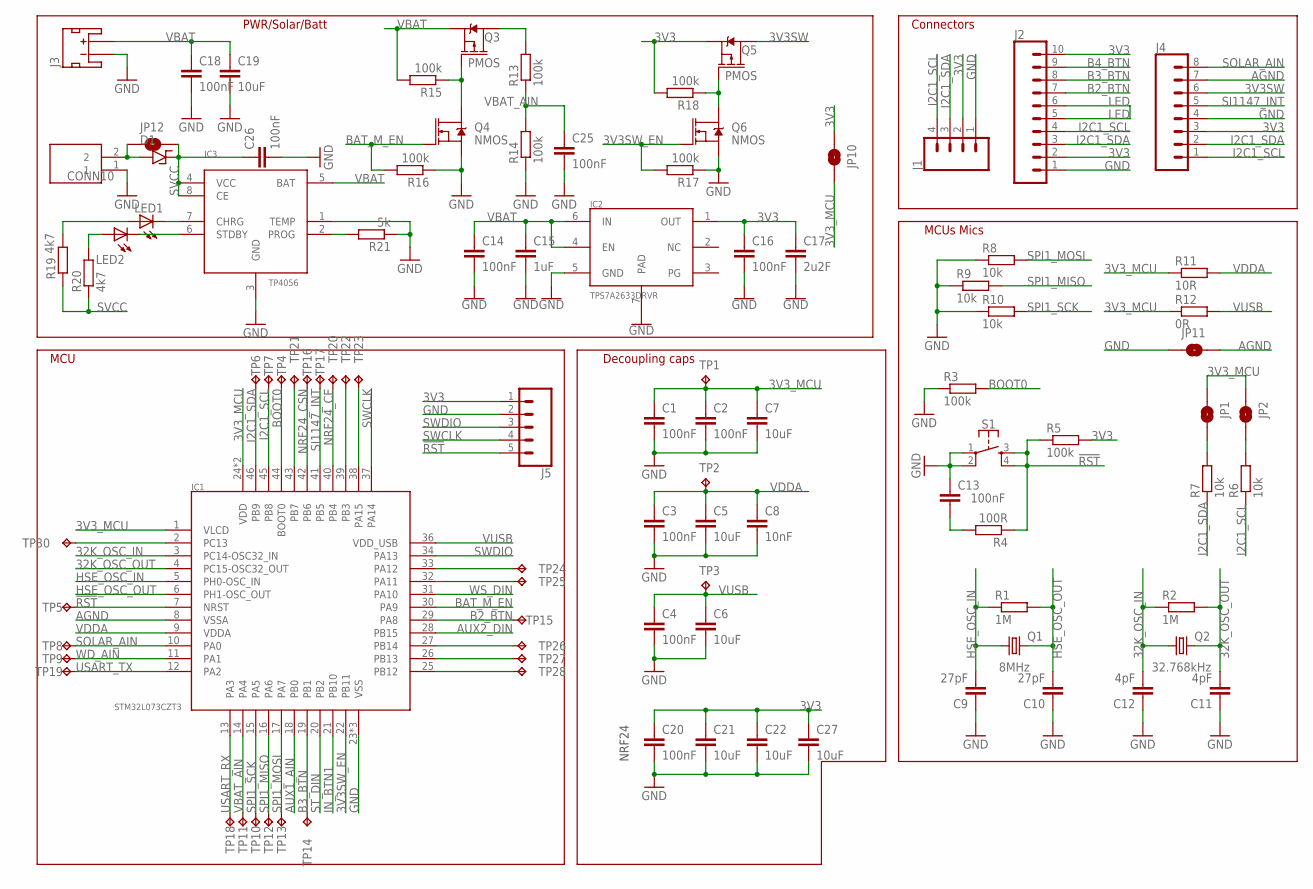
[picture p46: schematic Outdoor_unit_main_board.sch, sheet 1]

Parts:
C1, C2, C3, C4, C13, C14, C16, C18, C25, C26: 100nF; C0603K
C5, C6, C7, C19, C21, C22, C27: 10uF; C1206
C8: 10nF; C0603K
C9, C10: 27pF; C0603K
C11, C12: 4pF; C0603K
C15: 1uF; C0603K
C17: 2u2F; C0603K
C20: 100nF; C0603
CONN10: 1X02_SCREW_TERM; ASS_4091_CO
D1: SS24
IC1: STM32L073CZT3; LQFP-48
IC2: TPS7A2633DRVR; WSON-6
IC3: TP4056; SOP-8
J1: CONN_04; 1X04
J2: CONN_10"; 1X10
J3: JST_2MM_MALE; JST-2-SMD
J4: CONN_08"; 1X08
J5: CONN_05; 1X05
JP1, JP2, JP10, JP11, JP12: JUMPER-SMT_2_NO_SILK; SMT-JUMPER_2_NO_SILK
LED1, LED2: LEDCHIP-LED0805; CHIP-LED0805
Q1: 8MHz; HC49/S
Q2: 32.768kHz; TC26V
Q3, Q5: PMOS; SOT23-3
Q4, Q6: NMOS; SOT23-3
R1, R2: 1M; R0603
R3, R5, R13, R14, R15, R16, R17, R18: 100k; R0603
R4: 100R; R0603
R6, R7, R8, R9, R10: 10k; R0603
R11: 10R; R0603
R12: 0R; R0603
R19, R20: 4k7; R0603
R21: 5k; R0603
S1: MOMENTARY-SWITCH-SPST-2-SMD-5.2MM; TACTILE_SWITCH_SMD_5.2MM
TP1, TP2, TP3, TP4, TP5, TP6, TP7, TP8, TP9, TP10, TP11, TP12, TP13, TP14, TP15, TP16, TP17, TP18, TP19, TP20, TP21, TP22, TP23, TP24, TP25, TP26, TP27, TP28, TP30: TPTP15R; TP15R

Connections:
3V3: C16.1, C17.1, C20.1, C21.1, C22.1, C27.1, IC2.1 (OUT), J1.2, J2.2, J2.10, J4.3, J5.1, JP10.1, Q5.2 (S), R5.2, R18.2; also elsewhere on the board
3V3SW: J4.6, Q5.3 (D); also elsewhere on the board
3V3SW_EN: IC1.22 (PB11), Q6.1 (G), R17.2
3V3_MCU: C1.1, C2.1, C7.1, IC1.1 (VLCD), IC1.24 (VDD), IC1.48 (VDD), JP1.1, JP2.1, JP10.2, R11.1, R12.1, TP1.TP
32K_OSC_IN: C12.2, IC1.3 (PC14-OSC32_IN), Q2.1, R2.1
32K_OSC_OUT: C11.2, IC1.4 (PC15-OSC32_OUT), Q2.2, R2.2
!RST: IC1.7 (NRST), J5.5, R4.1, R5.1, S1.3, S1.4, TP5.TP
AGND: IC1.8 (VSSA), J4.7, JP11.2; also elsewhere on the board
AUX1_AIN: IC1.18 (PB0); also elsewhere on the board
AUX2_DIN: IC1.28 (PB15); also elsewhere on the board
B2_BTN: IC1.29 (PA8), J2.7, TP15.TP
B3_BTN: IC1.19 (PB1), J2.8, TP14.TP
B4_BTN: J2.9
BAT_M_EN: IC1.30 (PA9), Q4.1 (G), R16.2
BOOT0: IC1.44 (BOOT0), R3.2, TP4.TP
GND: C1.2, C2.2, C3.2, C4.2, C5.2, C6.2, C7.2, C8.2, C9.1, C10.1, C11.1, C12.1, C13.1, C14.2, C15.2, C16.2, C17.2, C18.2, C19.2, C20.2, C21.2, C22.2, C25.2, C26.2, C27.2, CONN10.1, IC1.23 (VSS), IC1.35 (VSS), IC1.47 (VSS), IC2.5 (GND), IC2.7 (PAD), IC3.1 (TEMP), IC3.3 (GND), J1.1, J2.1, J3.1 (-), J4.4, J5.2, JP11.1, Q4.2 (S), Q6.2 (S), R3.1, R8.1, R9.1, R10.1, R14.1, R16.1, R17.1, R21.1, S1.1, S1.2; also elsewhere on the board
HSE_OSC_IN: C9.2, IC1.5 (PH0-OSC_IN), Q1.1, R1.1
HSE_OSC_OUT: C10.2, IC1.6 (PH1-OSC_OUT), Q1.2, R1.2
I2C1_SCL: IC1.45 (PB8), J1.4, J2.4, J4.1, R6.1, TP7.TP; also elsewhere on the board
I2C1_SDA: IC1.46 (PB9), J1.3, J2.3, J4.2, R7.1, TP6.TP; also elsewhere on the board
IN_BTN1: IC1.21 (PB10); also elsewhere on the board
LED: J2.5, J2.6
unnamed: CONN10.2, D1.A, JP12.1
unnamed: JP1.2, R7.2
unnamed: C13.2, R4.2
unnamed: JP2.2, R6.2
unnamed: IC3.7 (CHRG), LED1.C
unnamed: IC3.6 (STDBY), LED2.C
unnamed: LED2.A, R20.2
unnamed: IC1.33 (PA12), TP24.TP
unnamed: IC1.32 (PA11), TP25.TP
unnamed: IC1.27 (PB14), TP26.TP
unnamed: IC1.26 (PB13), TP27.TP
unnamed: IC1.25 (PB12), TP28.TP
unnamed: IC1.38 (PA15), TP23.TP
unnamed: IC1.39 (PB3), TP22.TP
unnamed: IC1.43 (PB7), TP21.TP
unnamed: IC1.2 (PC13), TP30.TP
unnamed: Q3.3 (D), R13.2
unnamed: LED1.A, R19.2
unnamed: IC3.2 (PROG), R21.2
unnamed: Q3.1 (G), Q4.3 (D), R15.1
unnamed: Q5.1 (G), Q6.3 (D), R18.1
NRF24_CE: IC1.40 (PB4), TP20.TP; also elsewhere on the board
NRF24_CSN: IC1.42 (PB6), TP16.TP; also elsewhere on the board
SI1147_INT: IC1.41 (PB5), J4.5, TP17.TP
SOLAR_AIN: IC1.10 (PA0), J4.8, TP8.TP
SPI1_MISO: IC1.16 (PA6), R9.2, TP12.TP; also elsewhere on the board
SPI1_MOSI: IC1.17 (PA7), R8.2, TP13.TP; also elsewhere on the board
SPI1_SCK: IC1.15 (PA5), R10.2, TP10.TP; also elsewhere on the board
ST_DIN: IC1.20 (PB2); also elsewhere on the board
SVCC: C26.1, D1.C, IC3.4 (VCC), IC3.8 (CE), JP12.2, R19.1, R20.1
SWCLK: IC1.37 (PA14), J5.4
SWDIO: IC1.34 (PA13), J5.3
USART_RX: IC1.13 (PA3), TP18.TP
USART_TX: IC1.12 (PA2), TP19.TP
VBAT: C14.1, C15.1, C18.1, C19.1, IC2.4 (EN), IC2.6 (IN), IC3.5 (BAT), J3.2 (+), Q3.2 (S), R15.2
VBAT_AIN: C25.1, IC1.14 (PA4), R13.1, R14.2, TP11.TP
VDDA: C3.1, C5.1, C8.1, IC1.9 (VDDA), R11.2, TP2.TP
VUSB: C4.1, C6.1, IC1.36 (VDD_USB), R12.2, TP3.TP
WD_AIN: IC1.11 (PA1), TP9.TP; also elsewhere on the board
WS_DIN: IC1.31 (PA10); also elsewhere on the board

Notes on the sheet:
MCU
Decoupling caps
MCUs Mics
NRF24
PWR/Solar/Batt
Connectors

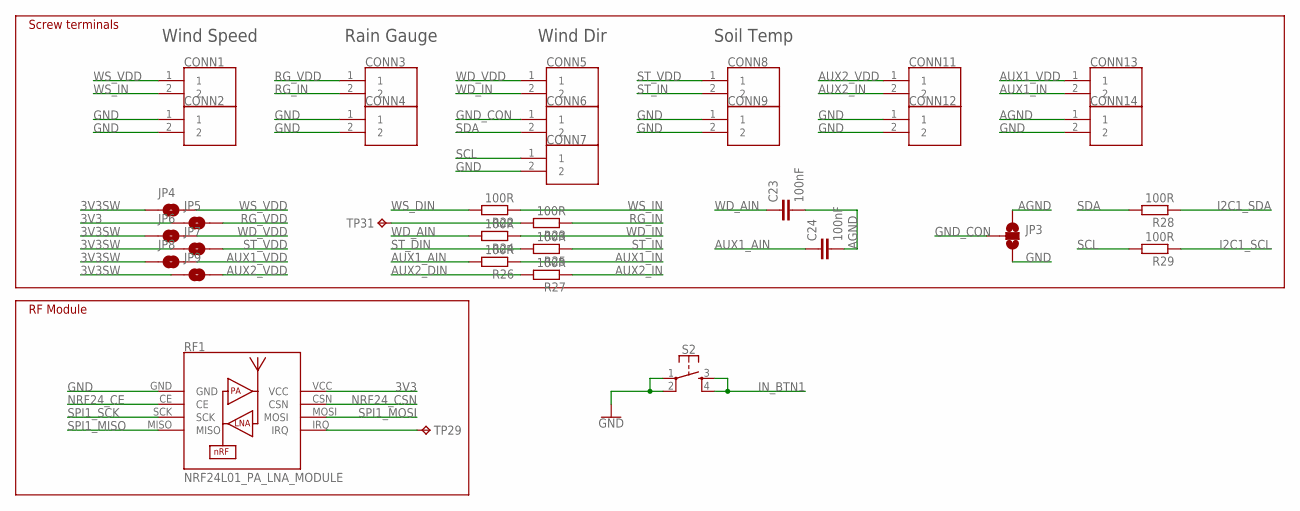
[picture p47: schematic Outdoor_unit_main_board.sch, sheet 2]

Parts:
C23, C24: 100nF; C0603K
CONN1, CONN2, CONN3, CONN4, CONN5, CONN6, CONN7, CONN8, CONN9, CONN11, CONN12, CONN13, CONN14: 1X02_SCREW_TERM; ASS_4091_CO
JP3: JUMPER-SMT_3_NO_SILK; SMT-JUMPER_3_NO_SILK
JP4, JP5, JP6, JP7, JP8, JP9: JUMPER-SMT_2_NO_SILK; SMT-JUMPER_2_NO_SILK
R22, R23, R24, R25, R26, R27, R28, R29: 100R; R0603
RF1: NRF24L01_PA_LNA_MODULE; NRF24L01_PA_LNA
S2: MOMENTARY-SWITCH-SPST-2-SMD-5.2MM; TACTILE_SWITCH_SMD_5.2MM
TP29, TP31: TPTP15R; TP15R

Connections:
3V3: JP5.1, RF1.VCC; also elsewhere on the board
3V3SW: JP4.1, JP6.1, JP7.1, JP8.1, JP9.1; also elsewhere on the board
AGND: C23.2, C24.2, CONN14.1, JP3.1; also elsewhere on the board
AUX1_AIN: C24.1, R26.2; also elsewhere on the board
AUX1_IN: CONN13.2, R26.1
AUX1_VDD: CONN13.1, JP8.2
AUX2_DIN: R27.2; also elsewhere on the board
AUX2_IN: CONN11.2, R27.1
AUX2_VDD: CONN11.1, JP9.2
GND: CONN2.1, CONN2.2, CONN4.1, CONN4.2, CONN7.2, CONN9.1, CONN9.2, CONN12.1, CONN12.2, CONN14.2, JP3.3, RF1.GND, S2.1, S2.2; also elsewhere on the board
GND_CON: CONN6.1, JP3.2
I2C1_SCL: R29.1; also elsewhere on the board
I2C1_SDA: R28.1; also elsewhere on the board
IN_BTN1: S2.3, S2.4; also elsewhere on the board
unnamed: RF1.IRQ, TP29.TP
unnamed: R23.2, TP31.TP
NRF24_CE: RF1.CE; also elsewhere on the board
NRF24_CSN: RF1.CSN; also elsewhere on the board
RG_IN: CONN3.2, R23.1
RG_VDD: CONN3.1, JP5.2
SCL: CONN7.1, R29.2
SDA: CONN6.2, R28.2
SPI1_MISO: RF1.MISO; also elsewhere on the board
SPI1_MOSI: RF1.MOSI; also elsewhere on the board
SPI1_SCK: RF1.SCK; also elsewhere on the board
ST_DIN: R25.2; also elsewhere on the board
ST_IN: CONN8.2, R25.1
ST_VDD: CONN8.1, JP7.2
WD_AIN: C23.1, R24.2; also elsewhere on the board
WD_IN: CONN5.2, R24.1
WD_VDD: CONN5.1, JP6.2
WS_DIN: R22.2; also elsewhere on the board
WS_IN: CONN1.2, R22.1
WS_VDD: CONN1.1, JP4.2

Notes on the sheet:
Wind Speed
Rain Gauge
Wind Dir
Soil Temp
Screw terminals
RF Module

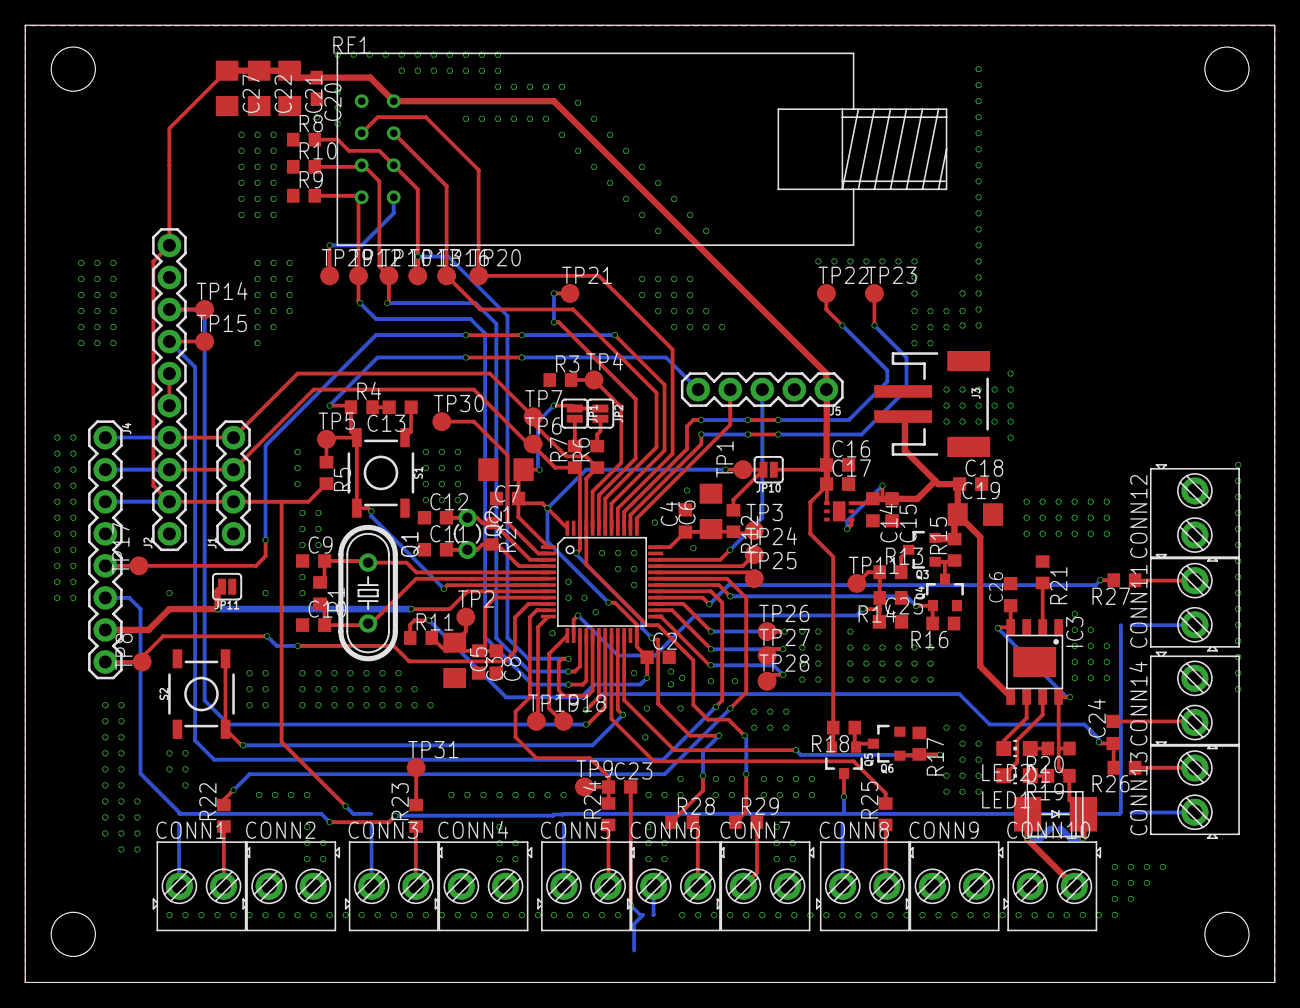
[picture p48: board Outdoor_unit_main_board.brd from above]

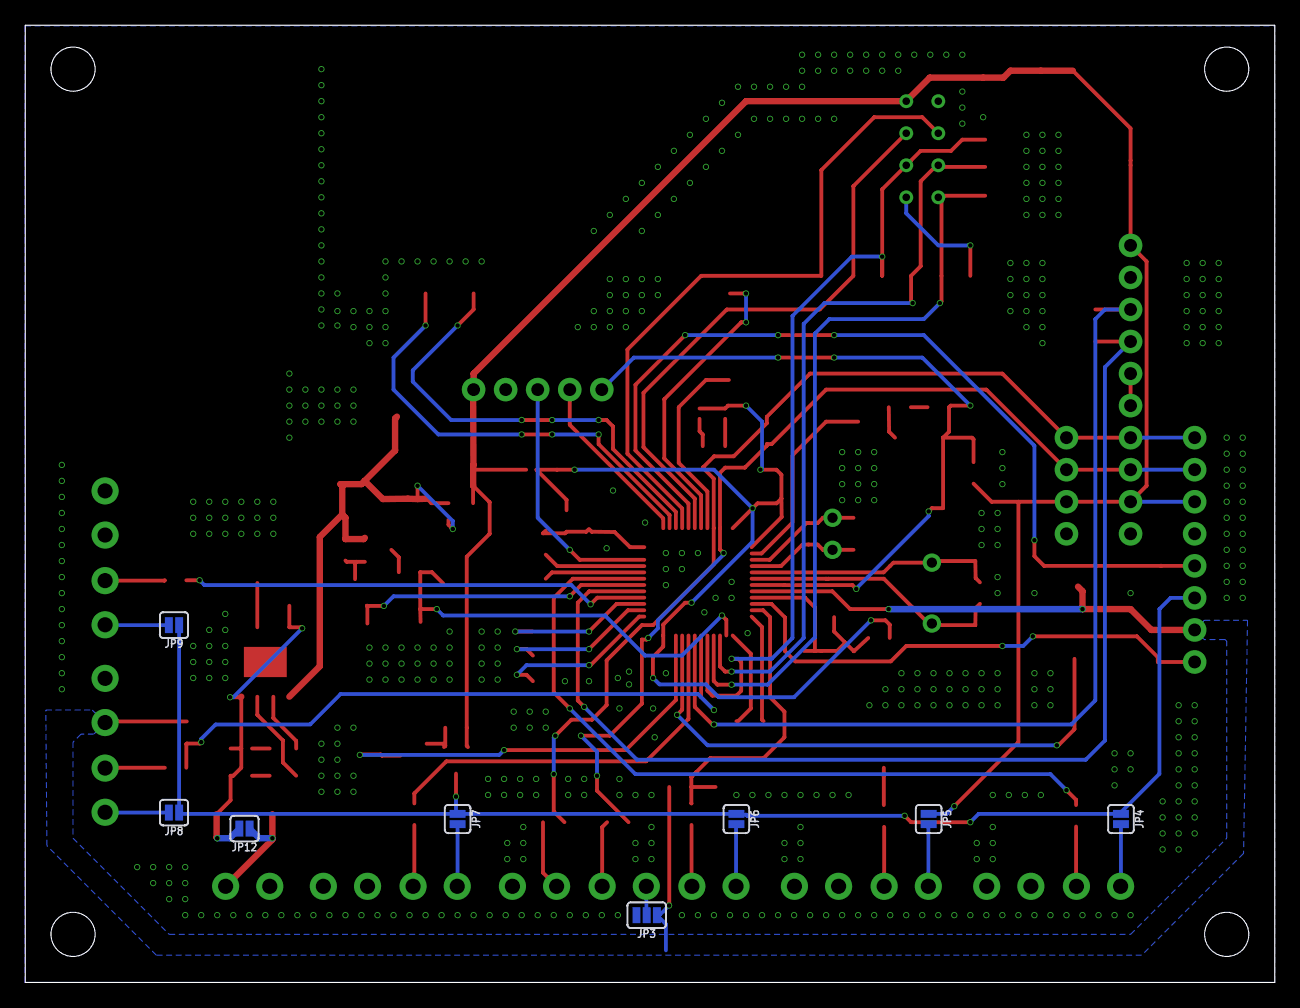
[picture p49: board Outdoor_unit_main_board.brd from below]

Board: 2 copper layers, 99.0 x 75.9 mm, 133 parts (8 on the bottom side), 78 nets.
