BornaBiro/Diplomski_rad/PCBs/Outdoor_unit_T_H_P_Board.brd

## EAGLE design PCBs/Outdoor_unit_T_H_P_Board.brd (2021-11-29)

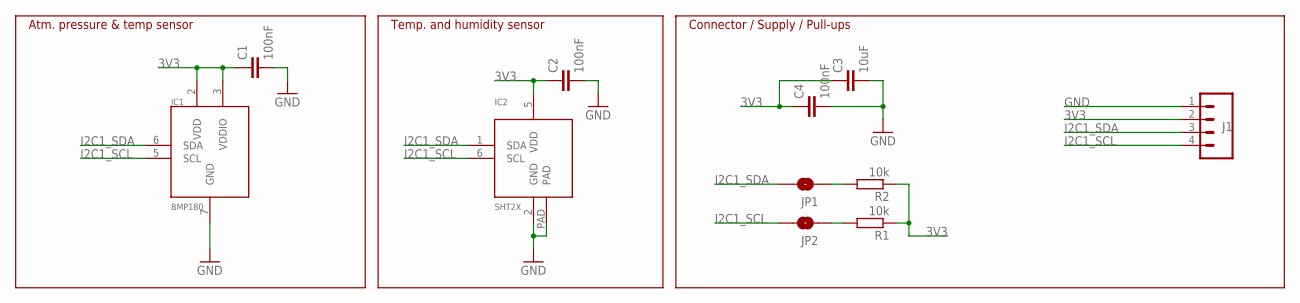
[picture p55: schematic Outdoor_unit_T_H_P_Board.sch]

Parts:
C1, C2, C4: 100nF; C0603K
C3: 10uF; C1206K
IC1: BMP180
IC2: SHT2X
J1: CONN_04; 1X04
JP1, JP2: JUMPER-SMT_2_NO_SILK; SMT-JUMPER_2_NO_SILK
R1, R2: 10k; R0603

Connections:
3V3: C1.1, C2.1, C3.1, C4.1, IC1.2 (VDD), IC1.3 (VDDIO), IC2.5 (VDD), J1.2, R1.1, R2.1
GND: C1.2, C2.2, C3.2, C4.2, IC1.7 (GND), IC2.2 (GND), IC2.PAD, J1.1
I2C1_SCL: IC1.5 (SCL), IC2.6 (SCL), J1.4, JP2.2
I2C1_SDA: IC1.6 (SDA), IC2.1 (SDA), J1.3, JP1.2
unnamed: JP2.1, R1.2
unnamed: JP1.1, R2.2

Notes on the sheet:
Atm. pressure & temp sensor
Temp. and humidity sensor
Connector / Supply / Pull-ups

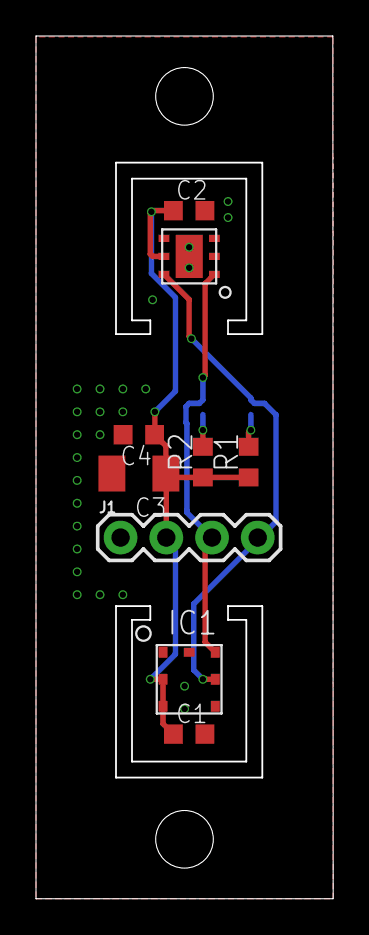
[picture p56: board Outdoor_unit_T_H_P_Board.brd from above]

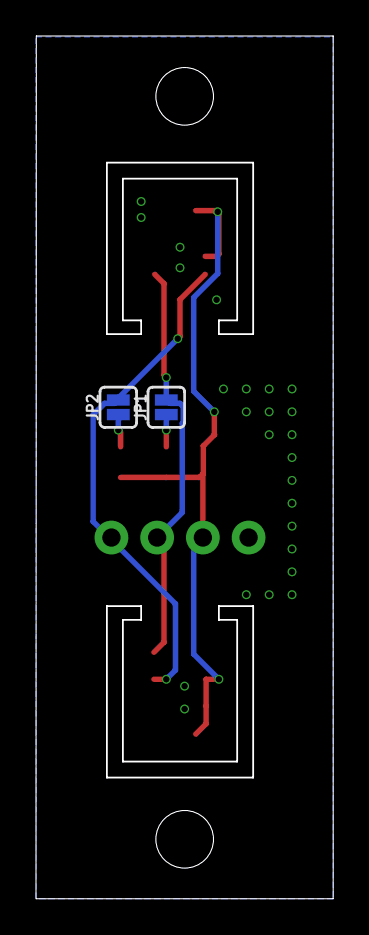
[picture p57: board Outdoor_unit_T_H_P_Board.brd from below]

Board: 2 copper layers, 16.5 x 47.9 mm, 11 parts (2 on the bottom side), 6 nets.
