BornaBiro/Diplomski_rad/PCBs/AS5600_Breakout.brd

## EAGLE design PCBs/AS5600_Breakout.brd (2021-11-29)

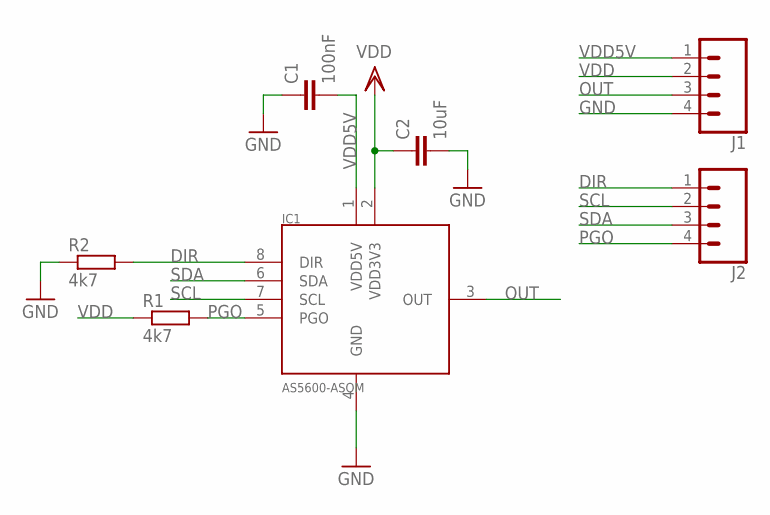
[picture p58: schematic AS5600_Breakout.sch]

Parts:
C1: 100nF; C0603K
C2: 10uF; C1206K
IC1: AS5600-ASOM; SOIC-8
J1, J2: CONN_04; 1X04
R1, R2: 4k7; R0603

Connections:
DIR: IC1.8 (DIR), J2.1, R2.2
GND: C1.1, C2.2, IC1.4 (GND), J1.4, R2.1
OUT: IC1.3 (OUT), J1.3
PGO: IC1.5 (PGO), J2.4, R1.2
SCL: IC1.7 (SCL), J2.2
SDA: IC1.6 (SDA), J2.3
VDD: C2.1, IC1.2 (VDD3V3), J1.2, R1.1
VDD5V: C1.2, IC1.1 (VDD5V), J1.1

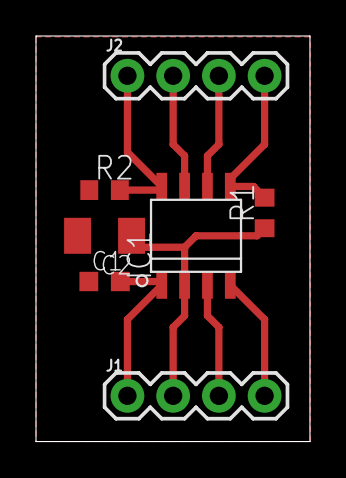
[picture p59: board AS5600_Breakout.brd from above]

Board: 2 copper layers, 15.2 x 22.5 mm, 7 parts (0 on the bottom side), 8 nets.
