BornaBiro/Diplomski_rad/Codes/Atollic/diplomski_outdoor/Src/main.c

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

/* Includes ------------------------------------------------------------------*/
#include "main.h"

/* USER CODE BEGIN Includes */
#include <stdlib.h>
#include <stdio.h>
#include <string.h>

#include "myStructs.h"
#include "glassLCD.h"
#include "SHT21.h"
#include "rtc.h"
#include "sleep.h"
#include "BMP180.h"
#include "Si1147.h"
#include "RF24.h"
#include "communication.h"
/* USER CODE END Includes */

/* USER CODE BEGIN PD */
#define TIME_HOURS() (((__TIME__[0] - '0') * 10) + ((__TIME__[1] - '0')))
#define TIME_MINUTES() (((__TIME__[3] - '0') * 10) + ((__TIME__[4] - '0')))
#define TIME_SECONDS() (((__TIME__[6] - '0') * 10) + ((__TIME__[7] - '0')))

#define NO_DEEP_SLEEP   0
#define DEEP_SLEEP      1
#define BMP180_ERROR    1
#define SHT21_ERROR     2
#define SI1147_ERROR    3
#define AS5600_ERROR    4
#define NRF24_ERROR     5
#define RTC_ERROR       6
/* USER CODE END PD */

ADC_HandleTypeDef hadc;

I2C_HandleTypeDef hi2c1;

RTC_HandleTypeDef hrtc;

SPI_HandleTypeDef hspi1;

UART_HandleTypeDef huart2;

/* USER CODE BEGIN PV */
struct syncStructHandle syncStruct = {SYNC_HEADER, 0, 300, 1800};
struct measruementHandle weatherData;
const char lcdTest[] = {"88888888"};
const char errStr[] = {"ERR-%03d"};
volatile uint32_t interruptButton = 0;
uint32_t sendInterval;
/* USER CODE END PV */

void SystemClock_Config(void);
static void MX_GPIO_Init(void);
static void MX_I2C1_Init(void);
static void MX_RTC_Init(void);
static void MX_SPI1_Init(void);
static void MX_USART2_UART_Init(void);
static void MX_ADC_Init(void);
/* USER CODE BEGIN PFP */
void writeError(uint8_t _e, uint8_t _forceSleep);
void readWeatherData(struct measruementHandle *_w);
/* USER CODE END PFP */

/**
  * @brief  The application entry point.
  * @retval int
  */
int main(void)
{
  

  /* MCU Configuration--------------------------------------------------------*/

  /* Reset of all peripherals, Initializes the Flash interface and the Systick. */
  HAL_Init();

  /* Configure the system clock */
  SystemClock_Config();

  /* Initialize all configured peripherals */
  MX_GPIO_Init();
  MX_I2C1_Init();
  MX_RTC_Init();
  MX_SPI1_Init();
  MX_USART2_UART_Init();
  MX_ADC_Init();
  /* USER CODE BEGIN 2 */

  // Init LCD Driver
  glassLCD_Begin();

  // Test LCD (and wait for debugger to connect)
  glassLCD_WriteData(lcdTest);
  glassLCD_SetDot(0b11111111);
  glassLCD_WriteArrow(0b11111111);
  glassLCD_Update();
  HAL_Delay(2000);

  // Init Pressure & Temp sensor
  if (!BMP180_Init()) writeError(BMP180_ERROR, DEEP_SLEEP);

  // Init Humidity & Temp sensor
  if (!SHT21_Init()) writeError(SHT21_ERROR, DEEP_SLEEP);

  // Init Si1147 Sensor for ALS and UV
  if (!Si1147_Init()) writeError(SI1147_ERROR, DEEP_SLEEP);

  RF24_init(NRF24_CE_GPIO_Port, NRF24_CE_Pin, NRF24_CSN_GPIO_Port, NRF24_CSN_Pin);
  if (!RF24_begin()) writeError(NRF24_ERROR, DEEP_SLEEP);

  // Enable UV meas.
  Si1147_SetUV();

  // Set time on RTC and alarm for wake up (FOR TEST ONLY!)
  RTC_SetTime(1609459200);

  // Setup RF communication (speed, RF Channel, RF Power, rtc)
  communication_Setup();

  // Wait for sync signal from indoor station
  if (communication_Sync(&syncStruct))
  {
      RTC_SetTime(syncStruct.myEpoch);
      RTC_SetAlarmEpoch(syncStruct.sendEpoch, RTC_ALARMMASK_DATEWEEKDAY);
      sendInterval = syncStruct.sendEpoch - syncStruct.myEpoch;
  }
  RF24_flush_rx();
  RF24_flush_tx();
  RF24_powerDown();
  /* USER CODE END 2 */
 
 

  /* Infinite loop */
  /* USER CODE BEGIN WHILE */
  uint8_t k = 0;
  while (1)
  {
	  char text[40];
	  glassLCD_Clear();
	  if (k == 0)
	  {
		  int16_t _hum = SHT21_ReadHumidity();
		  int16_t _t = SHT21_ReadTemperature();
		  sprintf(text, "%2d%01dC %2d%01d", _t / 100, abs(_t / 10 % 10), _hum / 100, abs(_hum / 10 % 10));
		  glassLCD_SetDot(0b01000010);
		  glassLCD_WriteArrow(0b10000000);
	  }
	  if (k == 1)
	  {
		  uint16_t _p = BMP180_ReadPressure();
		  sprintf(text, "%4d%1d", _p / 10, abs(_p % 10));
		  glassLCD_SetDot(0b00010000);
		  glassLCD_WriteArrow(0b01000000);
	  }
	  if (k == 2)
	  {
		  Si1147_ForceUV();
		  int16_t _uv = Si1147_GetUV();
		  int16_t _vis = Si1147_GetVis();
		  sprintf(text, "%03d %4d", _uv/10, (int)(_vis * 0.282 * 16.5));
		  glassLCD_SetDot(0b01000000);
		  glassLCD_WriteArrow(0b00100000);
	  }
	  if (k == 3)
	  {
		  // Calibrate ADC
		  HAL_ADCEx_Calibration_Start(&hadc, ADC_SINGLE_ENDED);
		  uint32_t rawAdc;
		  double voltage;
		  double current;
		  double energyJ;
		  double energy;
		  // Start ADC conversion
		  HAL_ADC_Start(&hadc);
		  // Wait for conversion to be coplete
		  HAL_ADC_PollForConversion(&hadc, 1000);
		  // Get the ADC value
		  rawAdc = HAL_ADC_GetValue(&hadc);
		  // Calculations for volage, current and energy
		  voltage = (rawAdc / 4095.0 * 3.3) - 0.0795;
		  current = voltage / (220 / 4.7);
		  energy = current / 45E-3 * 1000;
		  energyJ = (1 / 1E4) * energy * 600;
		  sprintf(text, "%2d%1d %4d", (int)(energyJ), (int)(energyJ * 10) % 10, (int)(energy));
		  glassLCD_SetDot(0b01000000);
		  glassLCD_WriteArrow(0b00010000);
	  }
	  glassLCD_WriteData(text);
	  glassLCD_Update();
	  //RTC_SetAlarmEpoch(RTC_GetEpoch() + 60, RTC_ALARMMASK_DATEWEEKDAY);
	  Sleep_LightSleep();
	  if (interruptButton == GPIO_PIN_8)
	  {
	      k++;
	      k = k % 4;
	  }
	  else
	  {
	      struct data1StructHandle data1Struct = {DATA1_HEADER};
	      readWeatherData(&weatherData);

	      data1Struct.hum = weatherData.humidity;
	      data1Struct.temp = weatherData.tempSHT;
	      data1Struct.pres = weatherData.pressure;

	      RF24_powerUp();
	      communication_Setup();

	      uint8_t rfBuffer[32];
	      uint8_t syncOk = 0;
	      uint8_t syncTimeout = 10;
	      uint32_t time1 = HAL_GetTick();
	      while (!syncOk && syncTimeout != 0)
	      {
	          if ((HAL_GetTick() - time1) > 1000)
	          {
	              time1 = HAL_GetTick();

	              char temp[10];
	              sprintf(temp, "SEND %d", syncTimeout--);
	              glassLCD_Clear();
	              glassLCD_WriteData(temp);
	              glassLCD_Update();

	              RF24_write(&data1Struct, sizeof(struct data1StructHandle), 0);
	              if (RF24_isAckPayloadAvailable())
	              {
	                  syncOk = 1;
	                  while (RF24_available(NULL))
	                  {
	                      RF24_read(rfBuffer, 32);
	                  }
	                  if (rfBuffer[0] == SYNC_HEADER)
	                  {
	                      memcpy(&syncStruct, rfBuffer, sizeof(syncStruct));
	                      RTC_SetTime(syncStruct.myEpoch);
	                      RTC_SetAlarmEpoch(syncStruct.sendEpoch, RTC_ALARMMASK_DATEWEEKDAY);
	                      sendInterval = syncStruct.sendEpoch - syncStruct.myEpoch;
	                      syncOk = 1;
	                      char debugTemp[100];
	                      sprintf(debugTemp, "Time: %ld Alarm: %ld RTC: %ld\r\n", syncStruct.myEpoch, syncStruct.sendEpoch, RTC_GetTime());
	                      HAL_UART_Transmit(&huart2, debugTemp, strlen(debugTemp), 1000);
	                  }
	              }
	          }
	      }
	      RF24_flush_rx();
	      RF24_flush_tx();
	      RF24_powerDown();
	      if (syncOk == 0) RTC_SetAlarmEpoch(RTC_GetTime() + sendInterval, RTC_ALARMMASK_DATEWEEKDAY);
	  }
    /* USER CODE END WHILE */

    /* USER CODE BEGIN 3 */
  }
  /* USER CODE END 3 */
}

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
/* USER CODE BEGIN 4 */
void writeError(uint8_t _e, uint8_t _forceSleep)
{
  char _c[9];
  sprintf(_c, errStr, _e);
  glassLCD_Clear();
  glassLCD_WriteData(_c);
  glassLCD_Update();
  HAL_Delay(50);
  if (_forceSleep) HAL_PWR_EnterSTANDBYMode();
}

void readWeatherData(struct measruementHandle *_w)
{
    _w->humidity = SHT21_ReadHumidity() / 100.0;
    _w->tempSHT = SHT21_ReadTemperature() / 100.0;
    _w->pressure = BMP180_ReadPressure() / 10.0;
}

void HAL_GPIO_EXTI_Callback(uint16_t GPIO_Pin)
{
    interruptButton = GPIO_Pin;
}

/* USER CODE END 4 */
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
