BornaBiro/Diplomski_rad/Codes/Arduino/Codes/outdoor_unit/realTimeClock.cpp

#include "realTimeClock.h"

Rtc::Rtc()
{

}

void Rtc::begin()
{
  __HAL_RCC_RTC_ENABLE();


  RTC_TimeTypeDef sTime = {0};
  RTC_DateTypeDef sDate = {0};
  RTC_AlarmTypeDef sAlarm = {0};

  /** Initialize RTC Only
  */
  hrtc.Instance = RTC;
  hrtc.Init.HourFormat = RTC_HOURFORMAT_24;
  hrtc.Init.AsynchPrediv = 127;
  hrtc.Init.SynchPrediv = 255;
  hrtc.Init.OutPut = RTC_OUTPUT_DISABLE;
  hrtc.Init.OutPutRemap = RTC_OUTPUT_REMAP_NONE;
  hrtc.Init.OutPutPolarity = RTC_OUTPUT_POLARITY_HIGH;
  hrtc.Init.OutPutType = RTC_OUTPUT_TYPE_OPENDRAIN;
  if (HAL_RTC_Init(&hrtc) != HAL_OK)
  {
    Error_Handler();
  }

  /** Initialize RTC and set the Time and Date
  */
  sTime.Hours = 0x0;
  sTime.Minutes = 0x0;
  sTime.Seconds = 0x0;
  sTime.DayLightSaving = RTC_DAYLIGHTSAVING_NONE;
  sTime.StoreOperation = RTC_STOREOPERATION_RESET;
  if (HAL_RTC_SetTime(&hrtc, &sTime, RTC_FORMAT_BCD) != HAL_OK)
  {
    Error_Handler();
  }
  sDate.WeekDay = RTC_WEEKDAY_MONDAY;
  sDate.Month = RTC_MONTH_JANUARY;
  sDate.Date = 0x1;
  sDate.Year = 0x0;

  if (HAL_RTC_SetDate(&hrtc, &sDate, RTC_FORMAT_BCD) != HAL_OK)
  {
    Error_Handler();
  }
  /** Enable the Alarm A
  */
  sAlarm.AlarmTime.Hours = 0x0;
  sAlarm.AlarmTime.Minutes = 0x0;
  sAlarm.AlarmTime.Seconds = 0x0;
  sAlarm.AlarmTime.SubSeconds = 0x0;
  sAlarm.AlarmTime.DayLightSaving = RTC_DAYLIGHTSAVING_NONE;
  sAlarm.AlarmTime.StoreOperation = RTC_STOREOPERATION_RESET;
  sAlarm.AlarmMask = RTC_ALARMMASK_NONE;
  sAlarm.AlarmSubSecondMask = RTC_ALARMSUBSECONDMASK_ALL;
  sAlarm.AlarmDateWeekDaySel = RTC_ALARMDATEWEEKDAYSEL_DATE;
  sAlarm.AlarmDateWeekDay = 0x1;
  sAlarm.Alarm = RTC_ALARM_A;
  if (HAL_RTC_SetAlarm_IT(&hrtc, &sAlarm, RTC_FORMAT_BCD) != HAL_OK)
  {
    Error_Handler();
  }
}

void Rtc::setTime(uint8_t _h, uint8_t _m, uint8_t _s)
{
  sTime.Hours = _h;
  sTime.Minutes = _m;
  sTime.Seconds = _s;
  HAL_RTC_SetTime(&hrtc, &sTime, RTC_FORMAT_BIN);
}

void Rtc::setDate(uint8_t _d, uint8_t _m, uint16_t _y)
{
  sDate.Date = _d;
  sDate.Month = _m;
  sDate.Year = (_y % 100);
  HAL_RTC_SetDate(&hrtc, &sDate, RTC_FORMAT_BIN);
}

void Rtc::setEpoch(uint32_t _epoch)
{
  uint8_t _s, _mi, _h, _d, _mo;
  uint16_t _y;
  epochToTimeAndDate(_epoch, &_s, &_mi, &_h, &_d, &_mo, &_y);
  setTime(_h, _mi, _s);
  setDate(_d, _mo, _y);
}

struct tm Rtc::getRTCData()
{
  struct tm _t = {0};
  uint8_t _s, _mi, _h, _d, _mo;
  uint16_t _y;
  getTimeAndDate(&_s, &_mi, &_h, &_d, &_mo, &_y);
  _t.tm_sec = _s;
  _t.tm_min = _mi;
  _t.tm_hour = _h;
  _t.tm_mday = _d;
  _t.tm_mon = (_mo - 1);
  _t.tm_year = 100 + (_y % 100);
  _t.tm_isdst = -1;
  _t.tm_yday = 0;
  _t.tm_wday = 0;
  return _t;
}

uint32_t Rtc::getEpoch()
{
  struct tm _t = getRTCData();
  return mktime(&_t);
}

void Rtc::setAlarm(bool _state, uint32_t _mask)
{
  if (_state)
  {
    uint8_t _s, _m, _h, _d, _dummy1;
    uint16_t _dummy2;
    epochToTimeAndDate(_alarmEpoch, &_s, &_m, &_h, &_d, &_dummy1, &_dummy2);
    sTime.Seconds = _s;
    sTime.Minutes = _m;
    sTime.Hours = _h;
    sAlarm.AlarmTime = sTime;
    sAlarm.AlarmMask = _mask;
    sAlarm.AlarmSubSecondMask = RTC_ALARMSUBSECONDMASK_ALL;
    sAlarm.AlarmDateWeekDay = _d;
    sAlarm.AlarmDateWeekDaySel = RTC_ALARMDATEWEEKDAYSEL_DATE;
    sAlarm.Alarm = RTC_ALARM_A;
    HAL_RTC_SetAlarm_IT(&hrtc, &sAlarm, RTC_FORMAT_BIN);
    HAL_NVIC_SetPriority(RTC_IRQn, 2, 0);
    HAL_NVIC_EnableIRQ(RTC_IRQn);
  }
  else
  {
    HAL_RTC_DeactivateAlarm(&hrtc, RTC_ALARM_A);
    HAL_NVIC_DisableIRQ(RTC_IRQn);
  }
}

void Rtc::setAlarmEpoch(uint32_t _e)
{
  _alarmEpoch = _e;
}

uint32_t Rtc::getAlarmEpoch()
{
  return _alarmEpoch;
}

void Rtc::alarmFlag(uint8_t *_f)
{
  _alarmFlag = _f;
}

void Rtc::getTimeAndDate(uint8_t *_sec, uint8_t *_min, uint8_t *_hour, uint8_t *_day, uint8_t *_month, uint16_t *_year)
{
  HAL_RTC_GetTime(&hrtc, &sTime, RTC_FORMAT_BIN);
  HAL_RTC_GetDate(&hrtc, &sDate, RTC_FORMAT_BIN);
  *_hour = sTime.Hours;
  *_min = sTime.Minutes;
  *_sec = sTime.Seconds;
  *_day = sDate.Date;
  *_month = sDate.Month;
  *_year = sDate.Year;
}

uint32_t Rtc::timeAndDateToEpoch(uint8_t _sec, uint8_t _min, uint8_t _hour, uint8_t _day, uint8_t _month, uint16_t _year)
{
  struct tm _t = {0};
  _t.tm_sec = _sec;
  _t.tm_min = _min;
  _t.tm_hour = _hour;
  _t.tm_mday = _day;
  _t.tm_mon = (_month - 1);
  _t.tm_year = 100 + (_year % 100);
  _t.tm_isdst = -1;
  _t.tm_yday = 0;
  _t.tm_wday = 0;
  return mktime(&_t);
}

void Rtc::epochToTimeAndDate(uint32_t _ep, uint8_t *_sec, uint8_t *_min, uint8_t *_hour, uint8_t *_day, uint8_t *_month, uint16_t *_year)
{
  struct tm *_t;
  _epoch = _ep;
  _t = gmtime(_epochHandler);
  *_sec = _t->tm_sec;
  *_min = _t->tm_min;
  *_hour = _t->tm_hour;
  *_day = _t->tm_mday;
  *_month = (_t->tm_mon) + 1;
  *_year = (_t->tm_year) + 1900;
}

extern "C" void RTC_IRQHandler(void)
{
  HAL_RTC_AlarmIRQHandler(&hrtc);
}

extern "C" void HAL_RTC_AlarmAEventCallback(RTC_HandleTypeDef *hrtc)
{
  UNUSED(hrtc);
  *_alarmFlag = 0xff;
}
