BornaBiro/Diplomski_rad/Codes/Arduino/Codes/Experimental/LCD_Outdoor_Unit_newlcd/segments1.h

// DE 301-RS-20/6.35-3 Bare glass LCD panel
// byte array[S F E D I J K N H G L M A B C P]
// byte array[BP0 BP1 BP2 BP3 BP0 BP1 BP2 BP3 BP0 BP1 BP2 BP3 BP0 BP1 BP2 BP3]
// !!! LCD has weird pinout, connect LCD driver and LCD this way:
// LCD DRIVER -> LCD PIN: S0 -> LCDPIN1, S1 -> LCDPIN2, S3 -> LCDPIN36, S4 -> LCDPIN35!!!
#define BLANK 0b0000000000000000
#define SEGA  0b0000000000001000
#define SEGB  0b0000000000000100
#define SEGC  0b0000000000000010
#define SEGD  0b0001000000000000
#define SEGE  0b0010000000000000
#define SEGF  0b0100000000000000
#define SEGG  0b0000000001000000
#define SEGH  0b0000000010000000
#define SEGI  0b0000100000000000
#define SEGJ  0b0000010000000000
#define SEGK  0b0000001000000000
#define SEGL  0b0000000000100000
#define SEGM  0b0000000000010000
#define SEGN  0b0000000100000000
#define SEGS  0b1000000000000000
#define SEGP  0b0000000000000001 // Symbol

#define SPACE   (BLANK)
#define QUMARK  (SEGB|SEGF)
#define PERC    (SEGB|SEGE|SEGG)
#define APH     (SEGG)
#define OBRAC   (SEGA|SEGD|SEGE|SEGF)
#define CBRAC   (SEGA|SEGB|SEGC|SEGD)
#define MINUS   (SEGG|SEGK)
#define DOT     (SEGP)
#define STAR    (SEGG|SEGH|SEGI|SEGJ|SEGK|SEGL|SEGM|SEGN)
#define NUM0    (SEGA|SEGB|SEGC|SEGD|SEGE|SEGF|SEGL|SEGJ)
#define NUM1    (SEGB|SEGC|SEGJ)
#define NUM2    (SEGA|SEGB|SEGD|SEGE|SEGG|SEGK)
#define NUM3    (SEGA|SEGB|SEGC|SEGD|SEGG|SEGK)
#define NUM4    (SEGB|SEGC|SEGF|SEGG|SEGK)
#define NUM5    (SEGA|SEGC|SEGD|SEGF|SEGG|SEGK)
#define NUM6    (SEGA|SEGC|SEGD|SEGE|SEGF|SEGG|SEGK)
#define NUM7    (SEGA|SEGL|SEGJ)
#define NUM8    (SEGA|SEGB|SEGC|SEGD|SEGE|SEGF|SEGG|SEGK)
#define NUM9    (SEGA|SEGB|SEGC|SEGD|SEGF|SEGG|SEGK)
#define QUEST   (SEGA|SEGB|SEGK|SEGM)

#define LETA    (SEGA|SEGB|SEGC|SEGE|SEGF|SEGG|SEGK)
#define LETB    (SEGA|SEGB|SEGC|SEGD|SEGI|SEGK|SEGM)
#define LETC    (SEGA|SEGD|SEGE|SEGF)
#define LETD    (SEGA|SEGB|SEGC|SEGD|SEGI|SEGM)
#define LETE    (SEGA|SEGD|SEGE|SEGF|SEGG|SEGK)
#define LETF    (SEGA|SEGE|SEGF|SEGG)
#define LETG    (SEGA|SEGC|SEGD|SEGE|SEGF|SEGK)
#define LETH    (SEGB|SEGC|SEGE|SEGF|SEGG|SEGK)
#define LETI    (SEGA|SEGD|SEGI|SEGM)
#define LETJ    (SEGB|SEGC|SEGD|SEGE)
#define LETK    (SEGE|SEGF|SEGG|SEGJ|SEGN)
#define LETL    (SEGD|SEGE|SEGF)
#define LETM    (SEGB|SEGC|SEGE|SEGF|SEGH|SEGJ)
#define LETN    (SEGB|SEGC|SEGE|SEGF|SEGH|SEGN)
#define LETO    (SEGA|SEGB|SEGC|SEGD|SEGE|SEGF)
#define LETP    (SEGA|SEGB|SEGE|SEGF|SEGG|SEGK)
#define LETQ    (SEGA|SEGB|SEGC|SEGD|SEGE|SEGF|SEGN)
#define LETR    (SEGA|SEGB|SEGE|SEGF|SEGG|SEGK|SEGN)
#define LETS    (SEGA|SEGC|SEGD|SEGH|SEGK)
#define LETT    (SEGA|SEGI|SEGM)
#define LETU    (SEGB|SEGC|SEGD|SEGE|SEGF)
#define LETV    (SEGE|SEGF|SEGJ|SEGL)
#define LETW    (SEGB|SEGC|SEGE|SEGF|SEGL|SEGN)
#define LETX    (SEGH|SEGJ|SEGL|SEGN)
#define LETY    (SEGH|SEGJ|SEGM)
#define LETZ    (SEGA|SEGD|SEGJ|SEGL)
