BornaBiro/Diplomski_rad/(commit log)

2021-05-17 LCD files renamed to glassLCD, written LCD functions, fixed issue with RTC Alarm Interrupt
    NOTE FOR RTC ALARM INTERRUPT:
    Proper function name for RTC Interrupt handler is RTC_IRQHandler() NOT RTC_Alarm_IRQHandler() (that is used for STM32H7XX)!
    [glassLCD.cpp, glassLCD.h, outdoor_unit.ino, realTimeClock.cpp, realTimeClock.h, segments.h]
2021-05-21 Added STM32 Atollic TrueSTUDIO Code for Outdoor unit
    Switching from Arduino (STM32duino) because it's memory inefficient to STM32 Atollic TrueSTUDIO.
2021-05-25 Added sleep library, added BMP180 .c and .h files, fixed code for glassLCD library (dot problem)
    [BMP180.c, BMP180.h, diplomski_outdoor.ioc, glassLCD.c, glassLCD.h, main.c, segments.h]
2021-07-26 Added Si1147 driver, but still not finished and tested
2021-07-26 Finished Si1147 driver and added test code to main.c
    To-Do: Add error handler if sensors haven't been found (write some error on LCD).
    [Si1147.c, Si1147.h, diplomski_outdoor.ioc, main.c, main.h]
2021-08-17 Files split into folders, added modified NRF24L01 library for STM32 and Inkplate
2021-08-17 Remover pgm_read_byte from ESP32 RF24 lib, added CSN and CE pins in RF24_init function
2021-09-04 Added check for all sensors, added nRF24l01, added sync between indoor and outdoor unit
2021-09-19 Added second button for instant measurement on PB1 and changed button for changing display on PA8
2021-10-12 Added all Arduino experimental codes, added real nRF indoor unit communication example, added nRF communication on STM32 outdoor unit (and fixed all STM32 RTC errors)
    [AR1020T_Test_Code.ino, AS5600_Test_Code.ino, BU21029_Test_Code.ino, Inkplate_keyboard_textbox.ino, Inkplate_keyboard_textbox_List_WiFi.ino, Inkplate_keyboard_textbox_List_WiFi_TSC.ino, LCD_Outdoor_Unit.ino, LCD_Outdoor_Unit_dot_fix.ino]
2021-10-24 Added code for STM32L073 (outdoor unit PCB)
2021-10-25 Now all measured data is been transmitted, added functions for sync and sending data, fixed rounding error on LCD, LCD is now being cleared every time new data has been written, fixed compiler warnin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
    [RF24.c, communication.c, communication.h, glassLCD.c, main.c, main.h, myStructs.h, rtc.h]
2021-10-26 Fixed rounding error on solar data
    [main.c]
2021-10-28 Fixed UV readings bug, added abs() on some display values
    [main.c, myStructs.h]
2021-11-29 Added 3D models, PCBs, split into folders
    [2ml.FCStd, AS5600_Breakout.brd, AS5600_Breakout.sch, Ball_joint1.FCStd, Ball_joint2.FCStd, LCD_Board.brd, LCD_Board.sch, LCD_Board_2.brd]
2022-10-29 Added limit to the humidity, solar cell current change
    Added limit to the humidity (for some reason SHT21 could read more than 100.0% (ex. 100.5%).
    If 100% of RH is measured, remove dot for RH on LCD.
    Solar cell is 40mA, not 45mA.
2022-10-31 Added wind speed holder bar.
    [windSensorHolder.FCStd]
2022-11-06 Fixed humidity on LCD, fixed wind speed calculations
    There was a bug when humidity was around 99.55% (LCD will show 10.0%, because of the rounding).
    New calculation on wind speed (linear regression instead of power regression).
    [Diplomski_Outdoor_Unit.ioc, main.c]
